spacelab-ufsc/daughterboards/README.md

# daughterboards
OBDH 2.0 daughterboards
