spacelab-ufsc/daughterboards/Memory_Expansion_Daughter_Board/hardware/README.md

Hardware of the Memory Expansion Daughter Board
