spacelab-ufsc/daughterboards/Memory_Expansion_Daughter_Board/firmware/README.md

Firmware for Memory Expansion Daughter Board
