spacelab-ufsc/daughterboards/Memory_Expansion_Daughter_Board/doc/chapters/hardware.tex

%
% hardware.tex
%
% Copyright © 2020 by Universidade Federal de Santa Catarina.
%
% Memory Expansion Daughterboard of OBDH 2.0
%
% This work is licensed under the Creative Commons Attribution-ShareAlike 4.0
% International License. To view a copy of this license,
% visit http://creativecommons.org/licenses/by-sa/4.0/.
%

%
% \brief: Hardware chapter.
%
% \author: Yan Castro de Azeredo <yan.ufsceel@gmail.com>
%
% \institution: Universidade Federal de Santa Catarina (UFSC)
%
% \version: 0.1.0
%
% \date: 09/06/20 (DD/MM/YY)
%
%  Credits to Gabriel Mariano Marcelino <gabriel.mm8@gmail.com> for the creation of this template
%

\chapter{Hardware} \label{ch:hardware}

\begin{figure}[!ht]
    \begin{center}
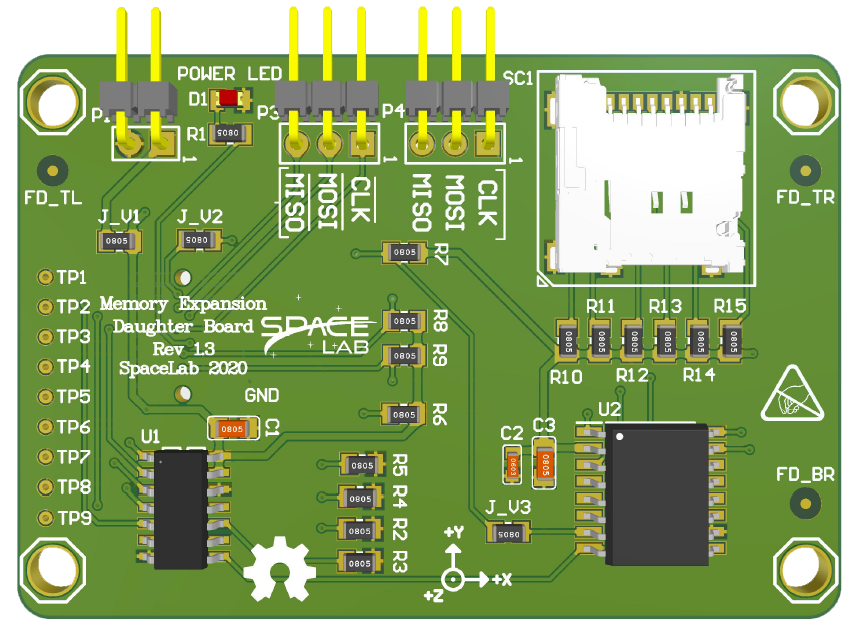
[picture p1: Memory_Expansion_Daughter_Board/doc/figures/TopView_DB_Memory.png]
        
        \caption{Top 3D view of the DB Memory PCB.}
        \label{fig:pcb-3d-TopView}
    \end{center}
\end{figure}

\begin{figure}[!ht]
    \begin{center}
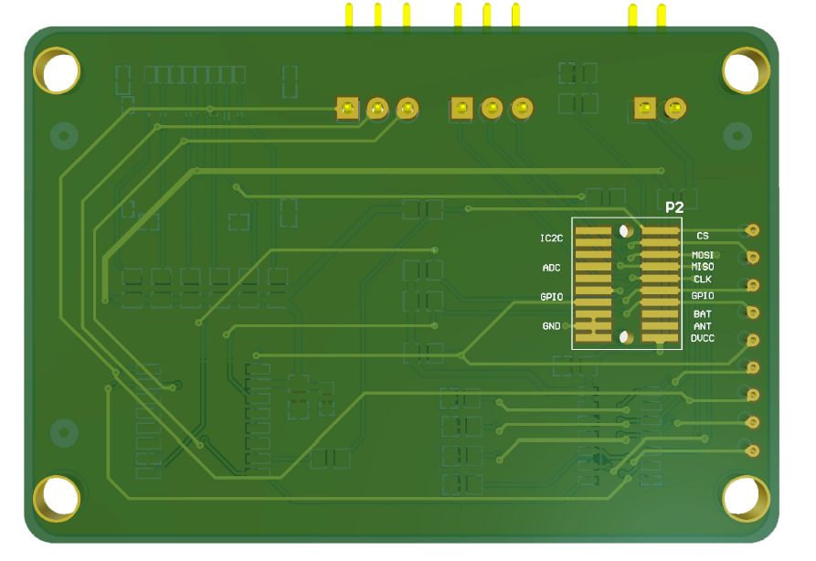
[picture p2: Memory_Expansion_Daughter_Board/doc/figures/BottomView_DB_Memory.png]
        
        \caption{Bottom 3D view of the DB Memory PCB.}
        \label{fig:pcb-3d-BottomView}
    \end{center}
\end{figure}
