spacelab-ufsc/daughterboards/Memory_Expansion_Daughter_Board/doc/chapters/introduction.tex

%
% introduction.tex
%
% Copyright © 2020 by Universidade Federal de Santa Catarina.
%
% Memory Expansion Daughterboard of OBDH 2.0
%
% This work is licensed under the Creative Commons Attribution-ShareAlike 4.0
% International License. To view a copy of this license,
% visit http://creativecommons.org/licenses/by-sa/4.0/.
%

%
% \brief: Introduction file.
%
% \author: Yan Castro de Azeredo <yan.ufsceel@gmail.com>
%
% \institution: Universidade Federal de Santa Catarina (UFSC)
%
% \version: 0.1.0
%
% \date: 09/06/20 (DD/MM/YY)
%
%  Credits to Gabriel Mariano Marcelino <gabriel.mm8@gmail.com> for the creation of this template
%

\chapter{Introduction} \label{ch:introduction}

The Memory Expansion Daughterboard (DB Memory in short) is a expansion module for the On-Boad-Data-Handling (OBDH 2) 
of FloripaSat-2 2U CubeSat. The main purpose of DB Memory is to give more 1gb non-volatile flash memory 
though an integrated circuit (MT25QL01GBBB) and more if added a micro sd card. 
While the module is not intended to go for flight in GOLDS-UFSC mission, 
the project had the main purpose to design the first board using the stadar SpaceLab daughter and motherboard relation 
and to serve as a prototype and testing printed circuit boards (PCB) for new comers in SpaceLab laboratory.

\begin{figure}[!ht]
    \begin{center}
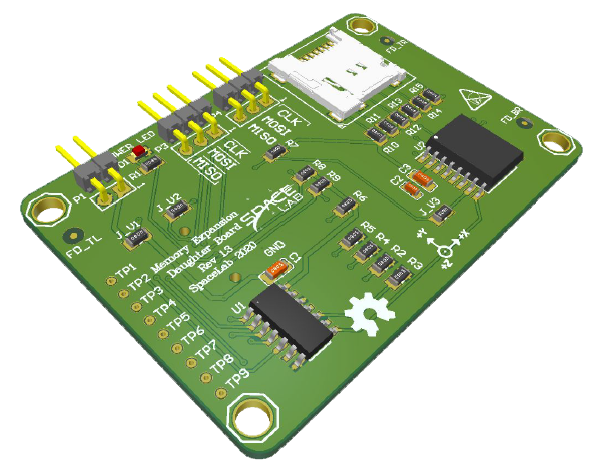
[picture p3: Memory_Expansion_Daughter_Board/doc/figures/DifferentView_DB_Memory.png]
        
        \caption{3D view of the DB Memory PCB.}
        \label{fig:pcb-3d-DifferentView}
    \end{center}
\end{figure}
