spacelab-ufsc/daughterboards/Memory_Expansion_Daughter_Board/doc/header/authorpage.tex

%
% authorpage.tex
%
% Copyright © 2020 by Universidade Federal de Santa Catarina.
%
% Memory Expansion Daughterboard of OBDH 2.0
%
% This work is licensed under the Creative Commons Attribution-ShareAlike 4.0
% International License. To view a copy of this license,
% visit http://creativecommons.org/licenses/by-sa/4.0/.
%

%
% \brief: Author page.
%
% \author: Yan Castro de Azeredo <yan.ufsceel@gmail.com>
%
% \institution: Universidade Federal de Santa Catarina (UFSC)
%
% \version: 0.1.0
%
% \date: 09/06/20 (DD/MM/YY)
%
%  Credits to Gabriel Mariano Marcelino <gabriel.mm8@gmail.com> for the creation of this template
%
\thispagestyle{empty}

\begin{center}

\textbf{\thetitle}

\textit{June, 2020}

\vspace{1cm}

\textbf{Project Chief:}

Eduardo Augusto Bezerra

\vspace{1cm}

\textbf{Authors:}

Yan Castro de Azeredo \\
Author 2 \\
Author 3 \\

\vspace{1cm}

\textbf{Contributing Authors:}

Author 1 \\
Author 2 \\
Author 3 \\

\vspace{1cm}

\textbf{Revision Control:}

\end{center}

\begin{table}[!ht]
    \begin{center}
        \begin{tabular}{cL{5cm}L{5.5cm}C{2cm}}
            \toprule[1.5pt]
            \textbf{Version} & \textbf{Author} & \textbf{Changes}    & \textbf{Date} \\
            \midrule
            0.1     & Yan Castro de Azeredo    & Document creation   & 06/2020    \\
                    &                          &                     &            \\
                    &                          &                     &            \\
                    &                          &                     &            \\
                    &                          &                     &            \\
            \bottomrule[1.5pt]
        \end{tabular}
    \end{center}
\end{table}

\vfill

\begin{figure}[!h]
	\begin{center}
		
	\end{center}
\end{figure}

\textcopyright\  2020 by Universidade Federal de Santa Catarina. Memory Expansion Daughterboard of OBDH 2.0. This work is licensed under the Creative Commons Attribution-ShareAlike 4.0 International License. To view a copy of this license, visit \href{http://creativecommons.org/licenses/by-sa/4.0/}{http://creativecommons.org/licenses/by-sa/4.0/}.
