spacelab-ufsc/daughterboards/Memory_Expansion_Daughter_Board/doc/main.pdf

SPACELAB.DB MEMORY.2020.06.001 REV A. ISSUE 0.1

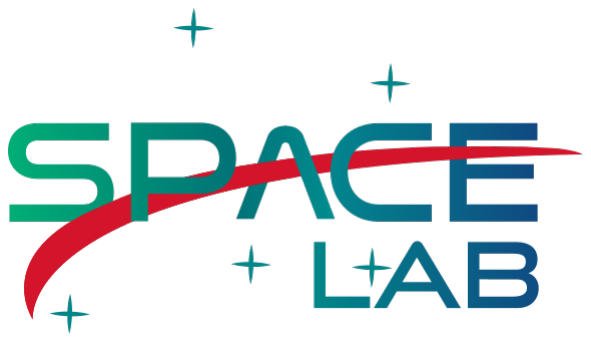
[picture p4: figure]

# Memory Expansion Daughterboard Documentation

Memory Expansion Daughterboard Documentation
SpaceLab, Universidade Federal de Santa Catarina, Florian´opolis - Brazil

June 2020

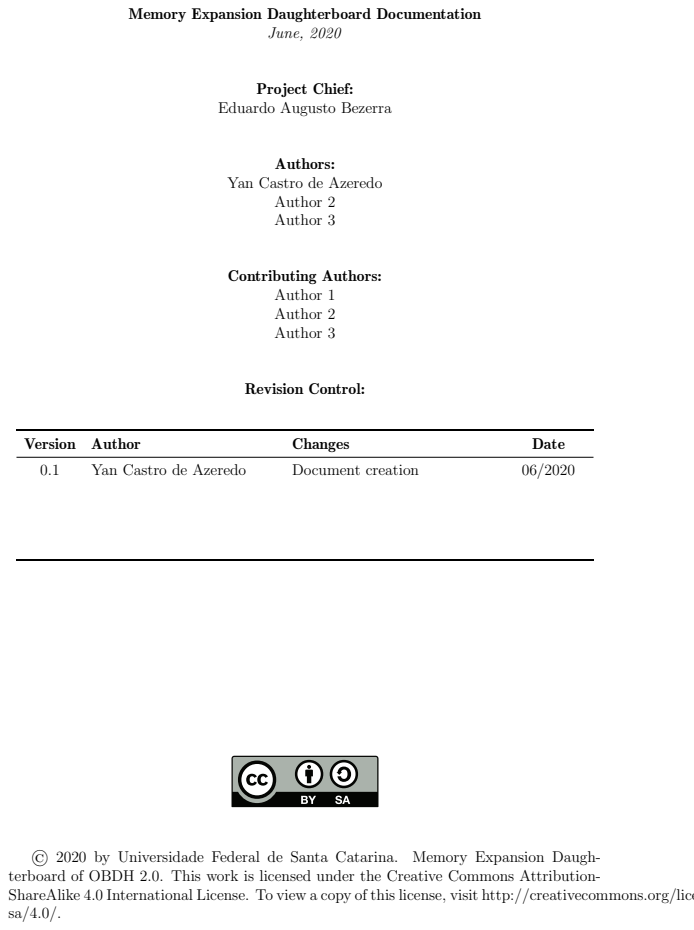
[picture p5: page 3]
June, 2020; Authors:; Author 2 Author 3; Contributing Authors: Author 1 Author 2 Author 3; Revision Control:; Version Author; Changes; Date; Yan Castro de Azeredo; Document creation

Memory Expansion Daughterboard Documentation

Project Chief:
Eduardo Augusto Bezerra

Yan Castro de Azeredo

© 2020 by Universidade Federal de Santa Catarina. Memory Expansion Daugh-
terboard of OBDH 2.0. This work is licensed under the Creative Commons Attribution-
ShareAlike 4.0 International License. To view a copy of this license, visit http://creativecommons.org/licenses/by-

## List of Figures

1.1 3D view of the DB Memory PCB | | 1
3.1 Top 3D view of the DB Memory PCB | | 5
3.2 Bottom 3D view of the DB Memory PCB | | 6

v

## List of Tables

vii

## Contents

List of Figures | v
Lista of Tables | vii
Nomenclature | vii
1 Introduction | 1
2 System Overview | 3
3 Hardware | 5
4 Firmware | 7
5 Usage Instructions | 9
References | 9

ix

## CHAPTER 1

## Introduction

The Memory Expansion Daughterboard (DB Memory in short) is a expansion module for the On-Boad-Data-Handling (OBDH 2) of FloripaSat-2 2U CubeSat. The main purpose of DB Memory is to give more 1gb non-volatile flash memory though an integrated circuit (MT25QL01GBBB) and more if added a micro sd card. While the module is not intended to go for flight in GOLDS-UFSC mission, the project had the main purpose to design the first board using the stadar SpaceLab daughter and motherboard relation and to serve as a prototype and testing printed circuit boards (PCB) for new comers in SpaceLab laboratory.

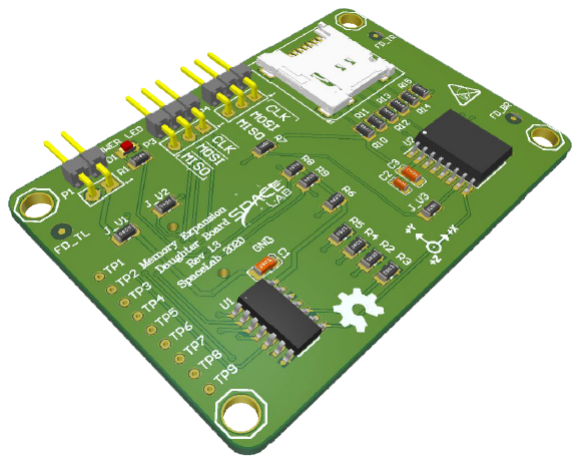
[picture p6: figure]

Figure 1.1: 3D view of the DB Memory PCB.

1

## CHAPTER 2

## System Overview

## 2.1 Block Diagram

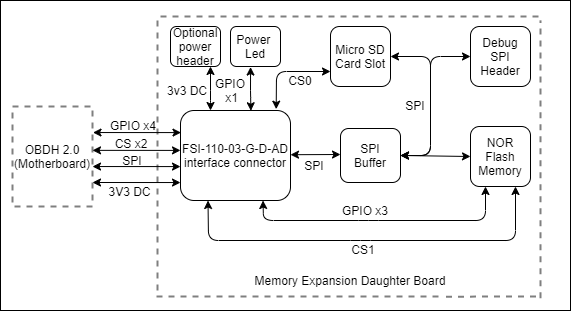
[picture p7: figure]

3

## CHAPTER 3

## Hardware

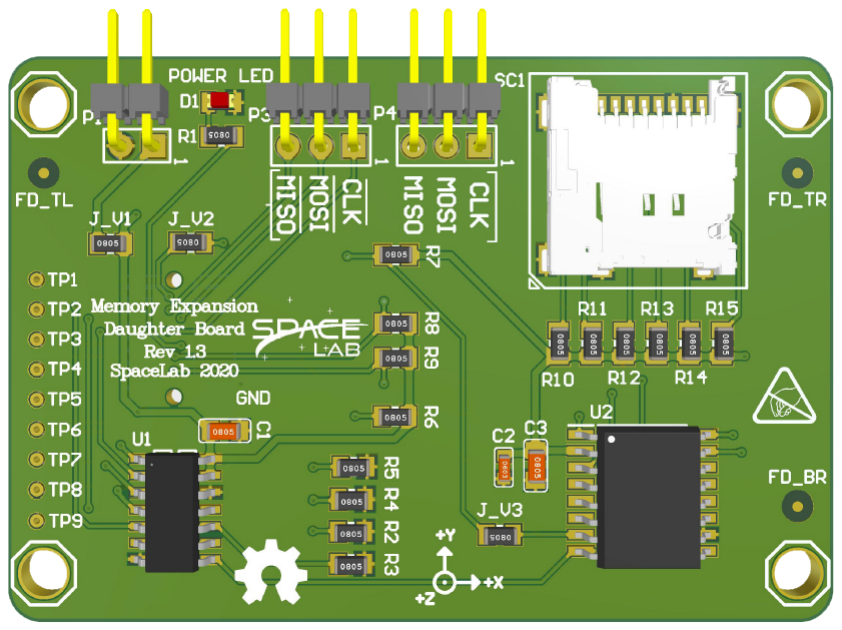
[picture p8: figure]

Figure 3.1: Top 3D view of the DB Memory PCB.

5

Chapter 3. Hardware

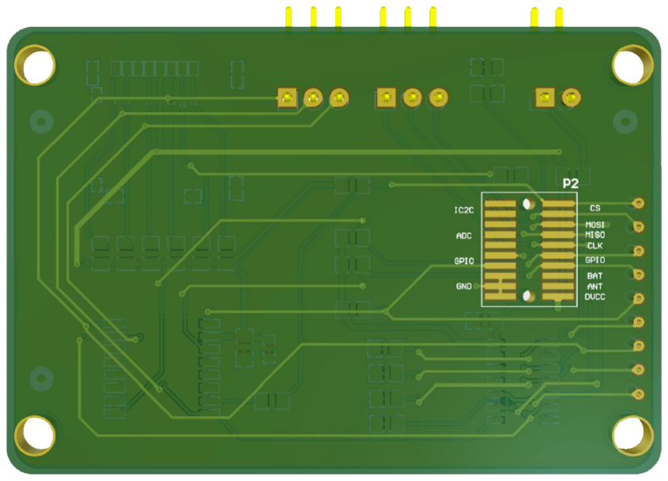
[picture p9: figure]

Figure 3.2: Bottom 3D view of the DB Memory PCB.

6

## CHAPTER 4

## Firmware

7

## CHAPTER 5

## Usage Instructions

9
