spacelab-ufsc/daughterboards/Memory_Expansion_Daughter_Board/hardware/PCB Design Checklist.xlsx

Excel sheet done by Kleber Reis Gouveia Júnior, Electronic Engineer, source: https://kleberrgouveia.wixsite.com/home/goodstuff
PCB Design Checklist
Project: Memory Expansion Daughter Board of OBDH 2.0 ALT Hardware |  |  | Revision: | 1.2
Variant: 1.0 |  |  | Date: | 2020-04-19
1. | Schematic
Description |  | OK | NOK | N/A | Comments
1.1 | 0R resistor to isolate power supplies. | X |  |  | Added to "POWER TEST" pin connector.
1.2 | Test points (power supplies, control and status signals, ...). | X
1.3 | Power indicator (LED). | X |  |  | Using GPIO 4.
1.4 | Initial state of control signals. | X
1.5 | Components power supplies (dual supply, voltage level). | X |  |  | Dual suply not necessary.
1.6 | Components polarity. |  |  | X
1.7 | Electrical junctions. | X
1.8 | Are there tatalum capacitors? Is it necessary? |  |  | X
1.9 | RC circuit (10k - 100nF) o uC RESET pin. |  |  | X
1.10 | uC programming/debug connector signals. | X
1.11 | Decoupling capacitors (10nF/100nF) on power supllies outputs. |  |  | X | OBDH 2.0 responsability.
1.12 | Decoupling capacitors (100nF) in power pins. | X |  |  | Used lower values of capacitance due to project aplication.
1.13 | Ferrite bead and decoupling capacitors in input signals from cables. | X |  |  | Only used extra capacitors on daughter board, ODBH 2.0 has ferrite breads and capacitors covered
1.14 | Differential pair rules. |  |  | X | This simple board design doesn't need it
1.15 | ESD, EFT, Surge Protection | X |  |  | Provided by mother board (OBDH 2.0) with a 1M ohm resistor connected to the structure
1.16 | Recompile project (C+R). | X
1.17 | Add Port Cross Reference (R+P+D). | X
2. | Layout
Description |  | OK | NOK | N/A | Comments
2.1 | Run DRC (T+D+R). | X
2.2 | Holes diameters (>=0,3mm). | X |  |  | FSI connector has 1.07 mm diameter alligment pin (AD version).
2.3 | Soldermask on thermal pads. | X
2.4 | Footprints - holes | X |  |  | Daughter Board PCB holes are standard for any variation.
2.5 | Footprints - dimensions (possible mirroring) |  | X* |  | *Only the FSI connector needing special revision for mating pads, no source found yet
2.6 | Pin 1 indication, component polarity indicator. | X |  |  | No polarity components on project.
2.7 | Compatibility between schematic models and pcb models. | X
2.8 | Track width | X |  |  | Power width of 0.508mm and all other tracks with 0.254mm (following standard of motherboard)
2.9 | Power lines | X
2.10 | Clearance between silk, silk to role and silk to silk. | X
2.11 | uC programming connector position. |  |  | X
2.12 | PCB stackup. | X |  |  | Same default thickness of OBDH 2.0
2.13 | PCB zoning. |  |  | X | This simple board design doesn't need it
2.14 | Copper tickness | X |  |  | Same default thickness of OBDH 2.0
2.15 | Tracks with controlled impedance. |  |  | X | Not a high speed design
2.16 | Heavy/Tall component on bottom layer. |  |  | X | Simple design that doesn't require it
2.17 | Acute angle on tracks. | X |  |  | No 90 degre tracks in pcb design
2.18 | Decoupling capacitors positioning. | X
2.19 | Company Logo. | X
2.20 | PCB code and revision | X
2.21 | Layers markers. |  |  | X | Only 2 layers.
2.22 | Stackup table. | X |  |  | Too large table and it is not yet know how to resize it in Altium 18.1.7
2.23 | Drill table. | X
2.24 | Silk RoHS, PB Free and ESD |  | X |  | Only ESD silk added
2.25 | Components fiducials. | X
2.26 | PCB fiducials. | X
2.27 | Mechanical holes. | X
2.28 | 3D .step bodies. | X
2.29 | Connectors counter parts assembly. |  |  | X | Simple design that doesn't require it
2.30 | Internal planes connections. | X |  |  | Only GND vias used in this simple 2 layer design
2.31 | Thermal reliefs between pads and poligons. | X
2.32 | Via stitching. |  |  | X | Simple design that doesn't require it
2.33 | Via tenting. | X
2.34 | Test points. | X
2.35 | Teadrops. | X
2.36 | Make PCB Re-annotate and SCH Back annotate. | X
3. | Documentation
Description |  | OK | NOK | N/A | Comments
3.1 | .OutJob file configuration. | X
3.2 | BOM.xls | X
3.3 | QUOTE.xls |  |  | X
3.4 | SCH.pdf | X |  |  | In a unified PDF containing layer prints, assembly drawings and BOM.
3.5 | GERBERS.zip | X
3.6 | NC Drill files.zip | X
3.7 | Pick and Place files.zip | X
3.8 | ODB++.zip | X
3.9 | Special Fabrication Instruction.pdf |  |  | X
4. | Technical Responsibles
Name |  | Role |  |  | Signature
4.1 | Yan Castro de Azeredo | Drawing
4.2 | André Martins Pio de Mattos | Reviewer and Support
4.3 | Gabriel Mariano Marcelino | Reviewer and Support
4.4 | Kleber Reis Gouveia Júnior | Reviewer and Support
