spacelab-ufsc/daughterboards/Memory_Expansion_Daughter_Board/README.md

## Memory Expansion Daughter Board for OBDH 2.0 (DB Memory)

<p align="center">

</p>

<p align="center">

</p>

<p align="center">

</p>
