spacelab-ufsc/daughterboards/Memory_Expansion_Daughter_Board/doc/header/titlepage.tex

%
% titlepage.tex
%
% Copyright © 2020 by Universidade Federal de Santa Catarina.
%
% Memory Expansion Daughterboard of OBDH 2.0
%
% This work is licensed under the Creative Commons Attribution-ShareAlike 4.0
% International License. To view a copy of this license,
% visit http://creativecommons.org/licenses/by-sa/4.0/.
%

%
% \brief: Title page.
%
% \author: Yan Castro de Azeredo <yan.ufsceel@gmail.com>
%
% \institution: Universidade Federal de Santa Catarina (UFSC)
%
% \version: 0.1.0
%
% \date: 09/06/20 (DD/MM/YY)
%
%  Credits to Gabriel Mariano Marcelino <gabriel.mm8@gmail.com> for the creation of this template
%
\begin{titlepage}

\thispagestyle{empty}

\begin{flushleft}
SPACELAB.DB MEMORY.2020.06.001 REV A. ISSUE 0.1
\end{flushleft}

\begin{figure}[!ht]
    \begin{flushleft}
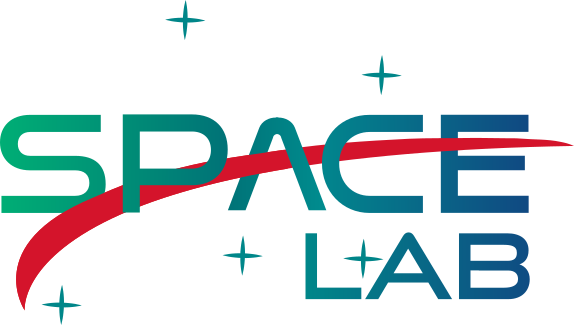
[picture p10: Memory_Expansion_Daughter_Board/doc/figures/LogotipoSpaceLab.png]
        
    \end{flushleft}
\end{figure}

\begin{flushleft}
\Huge{\textbf{\thetitle}}
\rule[0pt]{\textwidth}{5pt}
\end{flushleft}

\vspace{0.2cm}

\begin{flushleft}
\textit{Memory Expansion Daughterboard Documentation} \\
\textit{SpaceLab, Universidade Federal de Santa Catarina, Florianópolis - Brazil}
\end{flushleft}

\vfill
\vfill

\begin{flushright}
June 2020
\end{flushright}

\end{titlepage}
