spacelab-ufsc/daughterboards/Daughter_Board_Size_Shape/1_top_mating_pads_positioning.png

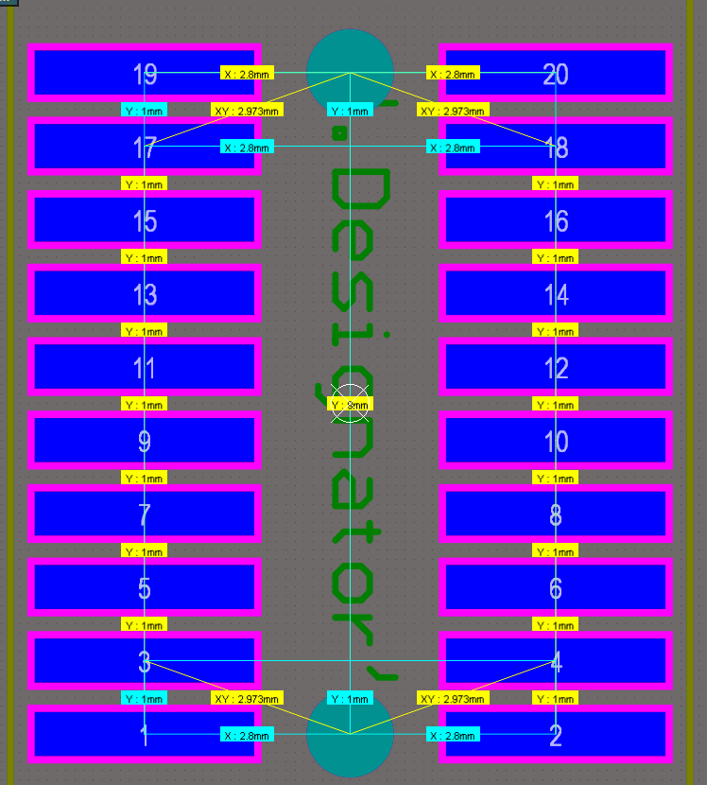
Daughter_Board_Size_Shape/1_top_mating_pads_positioning.png
