spacelab-ufsc/daughterboards/Daughter_Board_Size_Shape/2_top_mating_pads_size.png

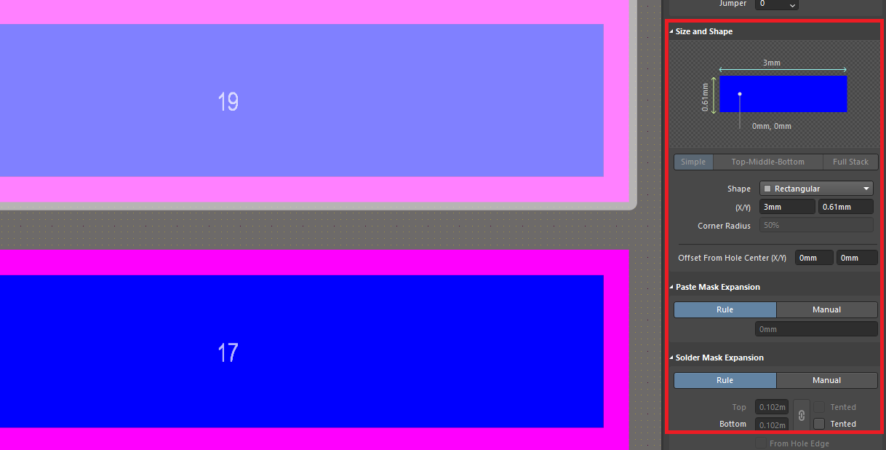
Daughter_Board_Size_Shape/2_top_mating_pads_size.png
