spacelab-ufsc/daughterboards/Daughter_Board_Size_Shape/3_connector_hole_size.png

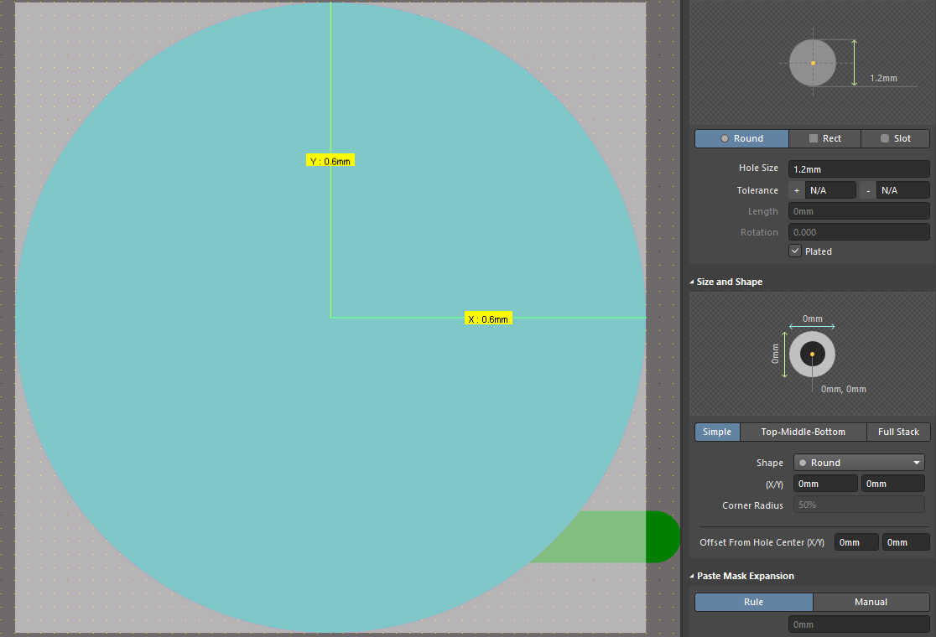
Daughter_Board_Size_Shape/3_connector_hole_size.png
