spacelab-ufsc/daughterboards/Daughter_Board_Size_Shape/4_connector_position.png

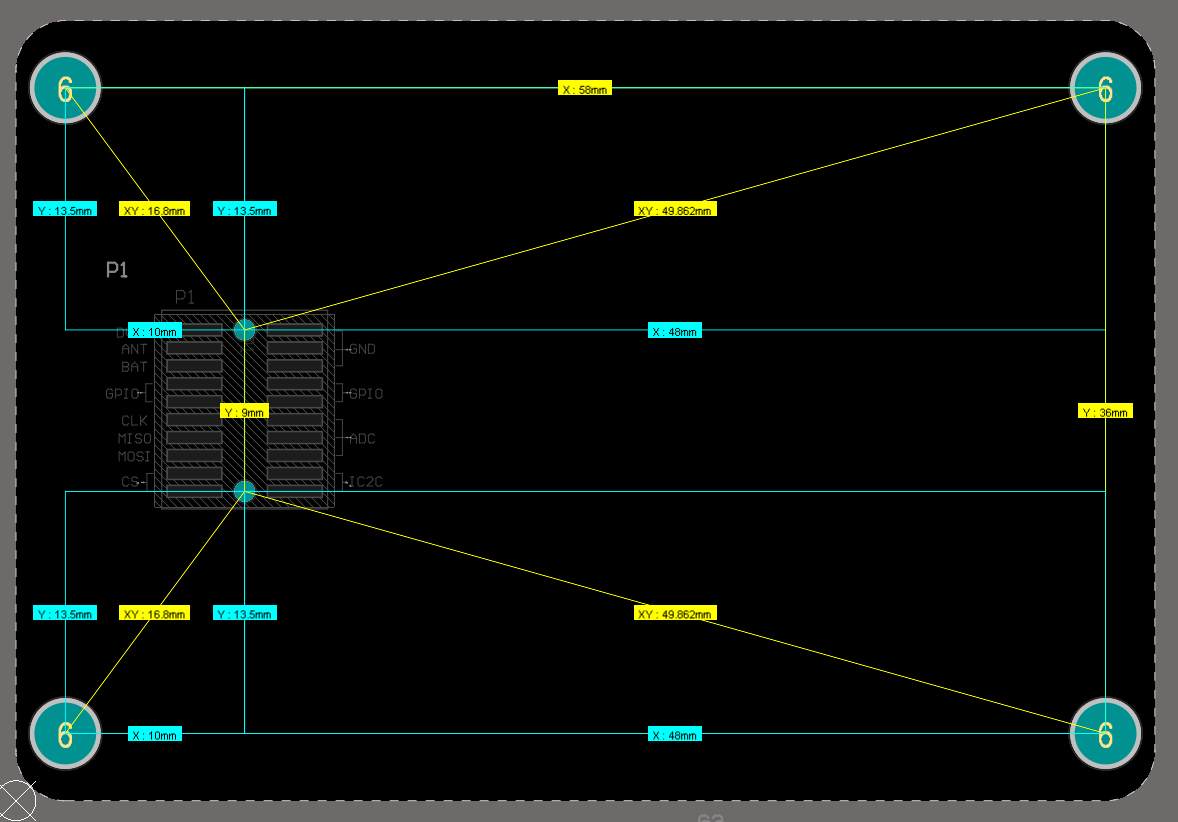
Daughter_Board_Size_Shape/4_connector_position.png
