spacelab-ufsc/daughterboards/Memory_Expansion_Daughter_Board/hardware/Output_files/Bill of Materials/Bill of Materials-DB_Memory.xlsx

 |  |  |  |  | Bill of Materials
 |  |  |  |  | Source Data From: | DB_Memory.PrjPCB
 |  |  |  |  | Project: | DB_Memory.PrjPCB
 |  |  |  |  | Variant: | None
 |  |  |  |  | Project Code: | <Parameter ProductCode not found>
 |  |  |  |  | Report Date: | 07/05/2020 | 11:25:48
 |  |  |  |  | Print Date: | 2020-05-07 | 11:26:10
# | Supplier 1 | Supplier Part Number 1 | Supplier 2 | Supplier Part Number 2 | Manufacturer | Comment | Description | Quantity | Designator | #Column Name Error:Fitted
1 | Digi-Key | 541-10.0KCCT-ND (https://octopart-clicks.com/click/altium?sku=541-10.0KCCT-ND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) | Mouser | 71-CRCW0805-10K-E3 (https://octopart-clicks.com/click/altium?sku=71-CRCW0805-10K-E3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) | Vishay | 10k | RES 10K OHM 1/8W 1% 0805 | 13 | R2, R3, R5, R6, R7, R8, R9, R10, R11, R12, R13, R14, R15
2 | Digi-Key | 311-0.0ARCT-ND (https://octopart-clicks.com/click/altium?sku=311-0.0ARCT-ND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) | Mouser | 603-RC0805JR-070RL (https://octopart-clicks.com/click/altium?sku=603-RC0805JR-070RL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) | Yageo | 0R | RES 0R OHM 1/8W JUMPER 0805 | 3 | J_V1, J_V2, J_V3
3 | Mouser | 200-TSW10308GSRA (https://octopart-clicks.com/click/altium?sku=200-TSW10308GSRA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) | Digi-Key | SAM1039-03-ND (https://octopart-clicks.com/click/altium?sku=SAM1039-03-ND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) | Samtec | HEADER 3x | Conn Unshrouded Header HDR 3 POS 2.54mm Solder RA Thru-Hole Automotive Bulk | 2 | P3, P4
4 | Digi-Key | 160-1413-1-ND (https://octopart-clicks.com/click/altium?sku=160-1413-1-ND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) | Mouser | 859-LTST-C170KFKT (https://octopart-clicks.com/click/altium?sku=859-LTST-C170KFKT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) | Vishay Lite-On | Orange | SMD Orange LED | 1 | D1
5 | Digi-Key | 296-1222-1-ND (https://octopart-clicks.com/click/altium?sku=296-1222-1-ND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) | Mouser | 595-SN74LVC125APWR (https://octopart-clicks.com/click/altium?manufacturer=Texas%20Instruments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) | Texas Instruments | SN74LVC125APWR | IC BUF NON-INVERT 3.6V 14TSSOP | 1 | U1
6 | Digi-Key | 311-100KCRCT-ND (https://octopart-clicks.com/click/altium?sku=311-100KCRCT-ND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) | Mouser | 603-RC0805FR-07100KL (https://octopart-clicks.com/click/altium?sku=603-RC0805FR-07100KL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) | Yageo | 100k | RES 100K OHM 1/8W 1% 0805 | 1 | R4
7 | Digi-Key | 311-1141-1-ND (https://octopart-clicks.com/click/altium?sku=311-1141-1-ND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) | Mouser | 603-CC805KRX7R8BB104 (https://octopart-clicks.com/click/altium?sku=603-CC805KRX7R8BB104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) | Yageo | 0.1uF/25V | CAP CER 0.1UF 25V 10% X7R 0805 | 1 | C1
8 | Digi-Key | 311-1401-1-ND (https://octopart-clicks.com/click/altium?sku=311-1401-1-ND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) | Mouser | 603-CC201KRX7R9BB101 (https://octopart-clicks.com/click/altium?sku=603-CC201KRX7R9BB101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) | Yageo | 100nF/50V | CAP CER 100nF 50V 0603 10% | 1 | C2
9 | Digi-Key | 587-2990-6-ND (https://octopart-clicks.com/click/altium?sku=587-2990-6-ND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) | Mouser | 963-TMK212AB7475KG-T (https://octopart-clicks.com/click/altium?sku=963-TMK212AB7475KG-T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) | Taiyo Yuden | 4.7uF/25V | CAP CER 4.7UF 25V 10% X7R 0805 | 1 | C3
10 | Digi-Key | 2019-RK73H2ATTD3300FCT-ND (https://octopart-clicks.com/click/altium?manufacturer=KOA%20Speer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) | Mouser | 660-RK73H2ATTD3300F (https://octopart-clicks.com/click/altium?sku=660-RK73H2ATTD3300F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) | KOA Speer | 330R | RES 330R OHM 1/4W 1% 0805 | 1 | R1
11 | Mouser | 200-FSI11003GDAD (https://octopart-clicks.com/click/altium?sku=200-FSI11003GDAD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) | Digi-Key | SAM9412-ND (https://octopart-clicks.com/click/altium?sku=SAM9412-ND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) | Samtec | FSI-110-03-G-D-AD | CONN STACKING 20POS SMD GOLD | 1 | P2
12 | Mouser | 200-TSW10208GSRA (https://octopart-clicks.com/click/altium?sku=200-TSW10208GSRA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) | Digi-Key | SAM1039-02-ND (https://octopart-clicks.com/click/altium?sku=SAM1039-02-ND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) | Samtec | HEADER 2x | Conn Unshrouded Header HDR 2 POS 2.54mm Solder RA Thru-Hole Automotive Bulk | 1 | P1
13 | Mouser | 340-278808-TRAY (https://octopart-clicks.com/click/altium?manufacturer=Micron%20Technology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) | Digi-Key | 557-1789-ND (https://octopart-clicks.com/click/altium?manufacturer=Micron%20Technology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) | Micron Technology | MT25QL01GBBB8ESF-0SIT | NOR Flash Serial-SPI 3V 1Gbit 1024M/512M/256M x 1bit/2bit/4bit 6ns 16-Pin SOP-II | 1 | U2
14 | Mouser | 538-503182-1852 (https://octopart-clicks.com/click/altium?sku=538-503182-1852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) | Digi-Key | WM12834CT-ND (https://octopart-clicks.com/click/altium?sku=WM12834CT-ND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) | Molex | MicroSD Card Connector | MOLEX - 503182-1852 - Micro SD Normal UltraLowPro8CktEmbsTpPkg RoHS Compliant: Yes | 1 | SC1
