spacelab-ufsc/daughterboards/Memory_Expansion_Daughter_Board/hardware/Output_files/Bill of Materials/BOM Template.xlsx

 |  |  |  |  | Bill of Materials
 |  |  |  |  | Source Data From: | Field=DataSourceFileName
 |  |  |  |  | Project: | Field=ProjectFileName
 |  |  |  |  | Variant: | Field=VariantName
 |  |  |  |  | Project Code: | Field=ProductCode
 |  |  |  |  | Report Date: | Field=ReportDate | Field=ReportTime
 |  |  |  |  | Print Date: | 2020-03-21 | 13:29:34
# | Column=Supplier 1 | Column=Supplier Part Number 1 | Column=Supplier 2 | Column=Supplier Part Number 2 | Column=Manufacturer | Column=Comment | Column=Description | Column=Quantity | Column=Designator | Column=Fitted
1
2
3
