spacelab-ufsc/daughterboards/Memory_Expansion_Daughter_Board/hardware/3D models/User Library-0603(1608M) Cap.step

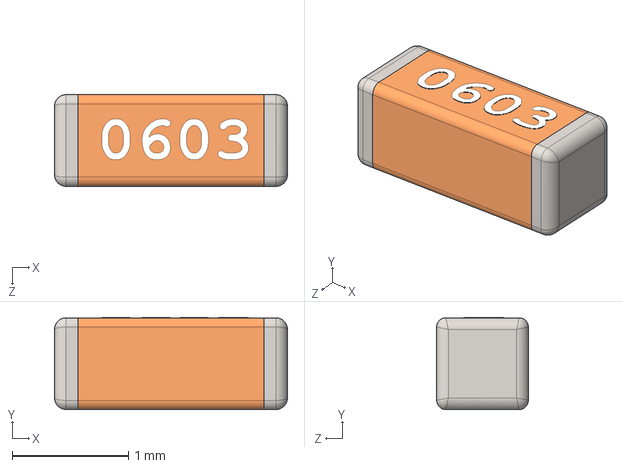
[picture p15: CAD file, 2020-02-14]
Memory_Expansion_Daughter_Board/hardware/3D models/User Library-0603(1608M) Cap.step
2.00 x 0.79 x 0.787 mm
