spacelab-ufsc/daughterboards/Memory_Expansion_Daughter_Board/hardware/3D models/User Library-0805(2012M) Cap.step

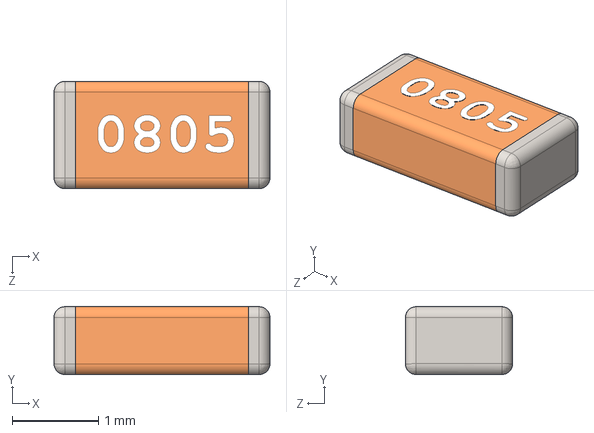
[picture p16: CAD file, 2020-02-14]
Memory_Expansion_Daughter_Board/hardware/3D models/User Library-0805(2012M) Cap.step
2.51 x 0.79 x 1.24 mm
