spacelab-ufsc/daughterboards/Memory_Expansion_Daughter_Board/hardware/3D models/User Library-led_0805.step

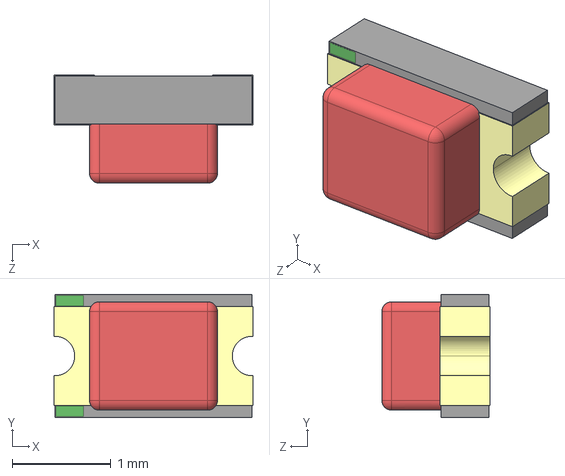
[picture p17: CAD file, 2020-02-14]
Memory_Expansion_Daughter_Board/hardware/3D models/User Library-led_0805.step
2.02 x 1.25 x 1.10 mm
