spacelab-ufsc/daughterboards/Memory_Expansion_Daughter_Board/hardware/3D models/PW14.step

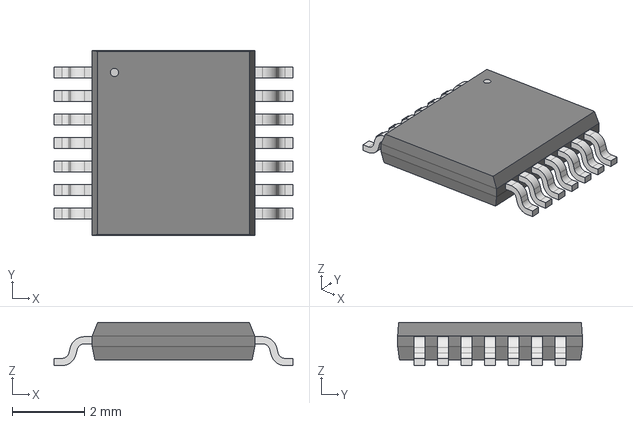
[picture p18: CAD file, 2020-02-14]
Memory_Expansion_Daughter_Board/hardware/3D models/PW14.step
6.60 x 5.11 x 1.20 mm
