spacelab-ufsc/daughterboards/Memory_Expansion_Daughter_Board/hardware/3D models/User Library-IPC SO.step

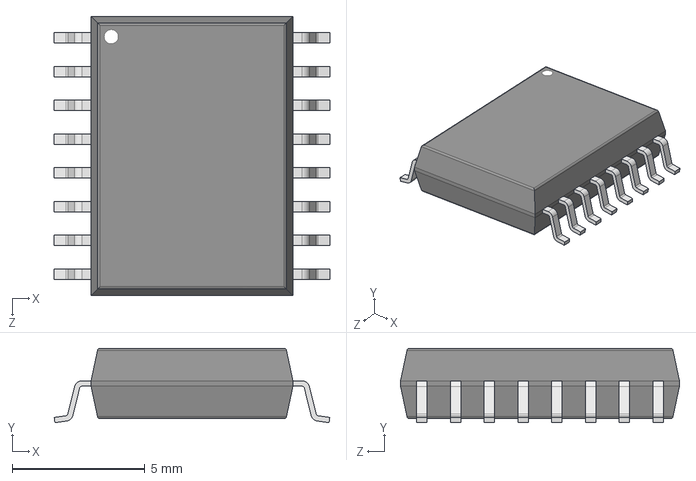
[picture p19: CAD file, 2020-02-14]
Memory_Expansion_Daughter_Board/hardware/3D models/User Library-IPC SO.step
10.4 x 2.80 x 10.5 mm
