spacelab-ufsc/daughterboards/Memory_Expansion_Daughter_Board/hardware/3D models/TSW-102-08-G-S-RA.stp

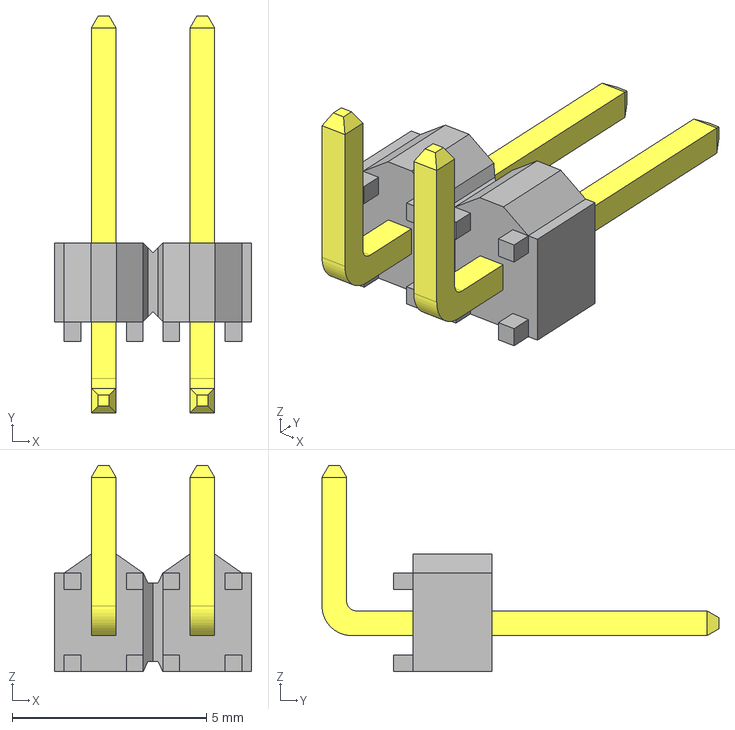
[picture p20: CAD file, 2020-02-04]
Memory_Expansion_Daughter_Board/hardware/3D models/TSW-102-08-G-S-RA.stp
5.08 x 10.2 x 5.31 mm
_TSW-102-08-G-S-RA_body
_T-1S6-08-TSW-1-08-2-RA-S
