spacelab-ufsc/daughterboards/Memory_Expansion_Daughter_Board/hardware/3D models/TSW-103-08-G-S-RA.stp

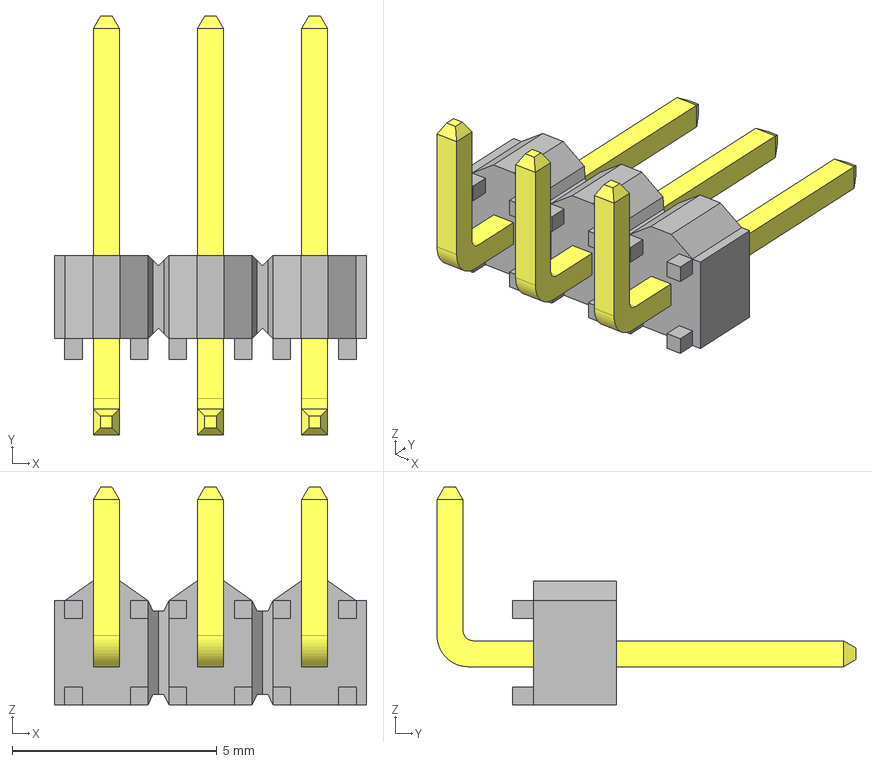
[picture p21: CAD file, 2020-02-04]
Memory_Expansion_Daughter_Board/hardware/3D models/TSW-103-08-G-S-RA.stp
7.62 x 10.2 x 5.31 mm
_TSW-103-08-G-S-RA_body
_T-1S6-08-TSW-1-08-3-RA-S
