spacelab-ufsc/daughterboards/Memory_Expansion_Daughter_Board/hardware/3D models/FSI-110-03-G-D-AD.stp

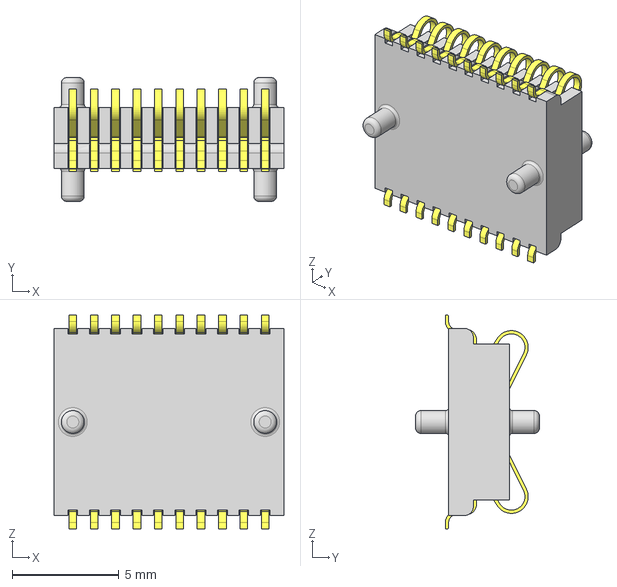
[picture p22: CAD file, 2020-02-04]
Memory_Expansion_Daughter_Board/hardware/3D models/FSI-110-03-G-D-AD.stp
10.8 x 5.80 x 10.0 mm
_FSI-110-03-G-D-AD_terminal
_FSI-110-03-D_pin x 2
