spacelab-ufsc/daughterboards/(list of files, cad)

Other CAD files:
Memory_Expansion_Daughter_Board/hardware/3D models/User Library-0805(2012M) Res.step
