spacelab-ufsc/daughterboards/Memory_Expansion_Daughter_Board/hardware/Multi_Board_Assembly_with_obdh2/Images/DB_ME_ODBH2_Assemble_XZ_plane_NegativeYaxis.png

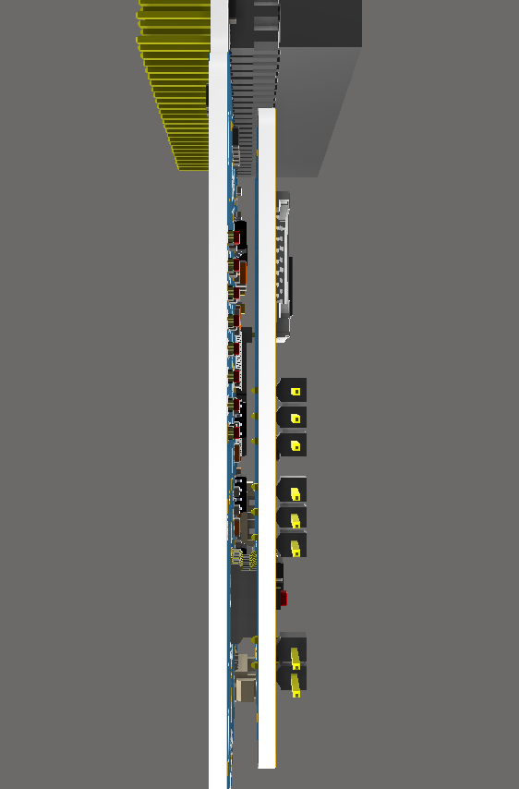
Memory_Expansion_Daughter_Board/hardware/Multi_Board_Assembly_with_obdh2/Images/DB_ME_ODBH2_Assemble_XZ_plane_NegativeYaxis.png
