spacelab-ufsc/daughterboards/Memory_Expansion_Daughter_Board/hardware/Multi_Board_Assembly_with_obdh2/Images/DB_ME_ODBH2_Assemble_Zaxis_distance.png

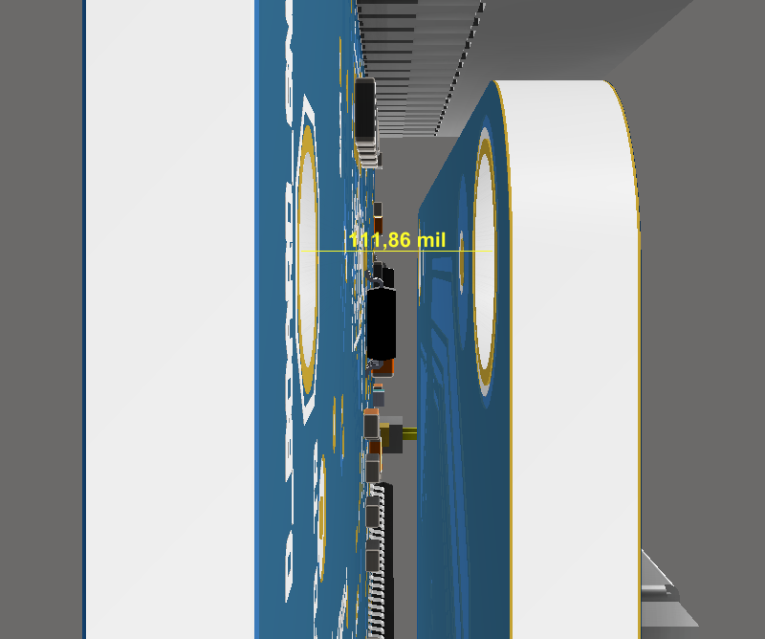
Memory_Expansion_Daughter_Board/hardware/Multi_Board_Assembly_with_obdh2/Images/DB_ME_ODBH2_Assemble_Zaxis_distance.png
