spacelab-ufsc/daughterboards/(threads)

Thread 1 (2020-01-28):

Define architecture and topology

andrempmattos, 2020-01-28:
Create 4 core schematic files: 0_Architecture, 1_Interface, 2_Non_Volatile_Memories and 3_Communication_Buffers.

Use two non volatile memory types (micro SD card and NOR flash, MT25QL01GBBB) and 1 SPI buffer (SN74LVC125A or similar).

andrempmattos, 2020-01-29:
16c9309cf4238662a09aade4e43ca6245ccd7089

andrempmattos, 2020-01-29:
e097bd7cd2205c9c41eca21c95c3306ac1006e75

Closed 2020-02-13.

Thread 3 (2020-01-28):

Create the "1_Interface" schematic sheet

andrempmattos, 2020-01-28:
Create the OBDH female connector([Samtec FSI-110-03-G-D-AD](https://www.samtec.com/products/fsi-110-03-g-d-ad)), Power on 3V3 LED and Debug Headers (before and after SPI buffer MOSI, MISO, CLK and CS signals and alternative power supply source).

Closed 2020-02-13.

Thread 4 (2020-01-28):

Create the "2_Non_Volatile_Memories" schematic sheet

andrempmattos, 2020-01-28:
Create SD card circuits (slot SD, capacitors and pull-up/down resistors) e NOR Flash Memory (memory, capacitors and pull-up/down resistors).

**Nor Flash Memory:** (MT25QL01GBBB8ESF)

From the [datasheet](https://www.micron.com/-/media/client/global/documents/products/data-sheet/nor-flash/serial-nor/mt25q/die-rev-b/mt25q_qlkt_l_01g_bbb_0.pdf) (page 79):

*"Normal precautions must be taken for supply line decoupling to stabilize the VCC supply. Each device in a system should have the VCC line decoupled by a suitable capacitor (**typically 100nF**) close to the package pins. At power-down, when VCC drops from the operating voltage to below the power-on-reset threshold voltage shown here, all operations are disabled and the device does not respond to any command."*

Reference design: [Technical Note - PCB Layout Design Guidelines](https://www.micron.com/-/media/client/global/documents/products/technical-note/nor-flash/tn2509_layout_guidelines_spi_nor_mt25q.pdf)

**SD Card:** (WM12834CT-ND)

Closed 2020-02-13.

Thread 6 (2020-01-28):

Create the PCB layout

andrempmattos, 2020-01-28:
**Preliminary Placement Suggestion:**
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

**Light brown:** SD card
**Dark red:** NOR Flash Memory
**Light blue:** Buffer IC
**Green:** 2.54mm Pitch Debug Headers
**Small blue and green shapes:** Passive components (resistors, capacitors and diodes)

Closed 2020-04-18.

Thread 7 (2020-01-28):

Perform a Multi Board Assembly between the Daughter Board and OBDH 2.0

andrempmattos, 2020-01-28:
[Multi Board Assembly](https://resources.altium.com/pcb-design-blog/the-best-tools-for-multi-board-pcb-systems-design)

Closed 2020-04-18.

Thread 12 (2020-02-14):

Add a PDF file with the schematics and top/bottom view of the 3D model of the PCB

mgm8, 2020-02-14:
Example: [Schematic_OBDH_Eng_Model_2_ALT_v02.pdf](https://github.com/spacelab-ufsc/obdh2/blob/master/hardware/Schematic_OBDH_Eng_Model_2_ALT_v02.pdf)

YanAzer, 2020-03-21:
Ontem fazendo o último documento do projeto (BOM) percebi que o resistor "RES 0R OHM 1/16W JUMPER 0805" usado tanto na OBDH Eng Model 2 como nesta placa filha não existe, pelo menos até onde pesquisei na Digi-Key e Mouser. O único package disponível para essa especificação de potência (1/16W) é o 0402, não achei nenhum que seja 0802 como especificado no Altium. @andrempmattos @mgm8

YanAzer, 2020-03-21:
Encontrei o partnumber no altium como sendo este: CRCW08050000Z0EA, pesquisando os resultados aparecem com o valor mínimo de 1/8W tendo o package de 0802 @andrempmattos @mgm8

YanAzer, 2020-03-21:
Ainda não consegui deixar o arquivo da BOM na Output Job File para pegar os parâmetros Do componente de memória e do cartão SD. Assim por enquanto atualizei manualmente neste commit https://github.com/spacelab-ufsc/daughterboards/commit/5777cbacb6b5473c9a48c96ffb7be911536bc317

YanAzer, 2020-03-24:
Agora o arquivo da BOM gerado automaticamente pelo Output Job File está pegando todos os parâmetros da template menos da coluna "fitted". O componente "RES 0R OHM 1/16W JUMPER 0805" foi alterado por um do mesmo package (0805) com valor de potência 1/8W, mais especificamente este aqui (https://www.digikey.com/products/en?keywords=311-0.0ARCT-ND) que também possuímos em estoque.

Closed 2020-04-18.

Thread 15 (2020-03-21):

Finish remaining output files for project

YanAzer, 2020-03-21:
1-) .OutJob file configuration
2-) BOM.xls
3-) QUOTE.xls
4-) SCH.pdf
5-) GERBERS.zip
6-) NC Drill files.zip
7-) Pick and Place files.zip
8-) ODB++.zip

Closed 2020-03-24.
