spacelab-ufsc/daughterboards/Memory_Expansion_Daughter_Board/hardware/Output_files/PDF/DB_Memory.PDF

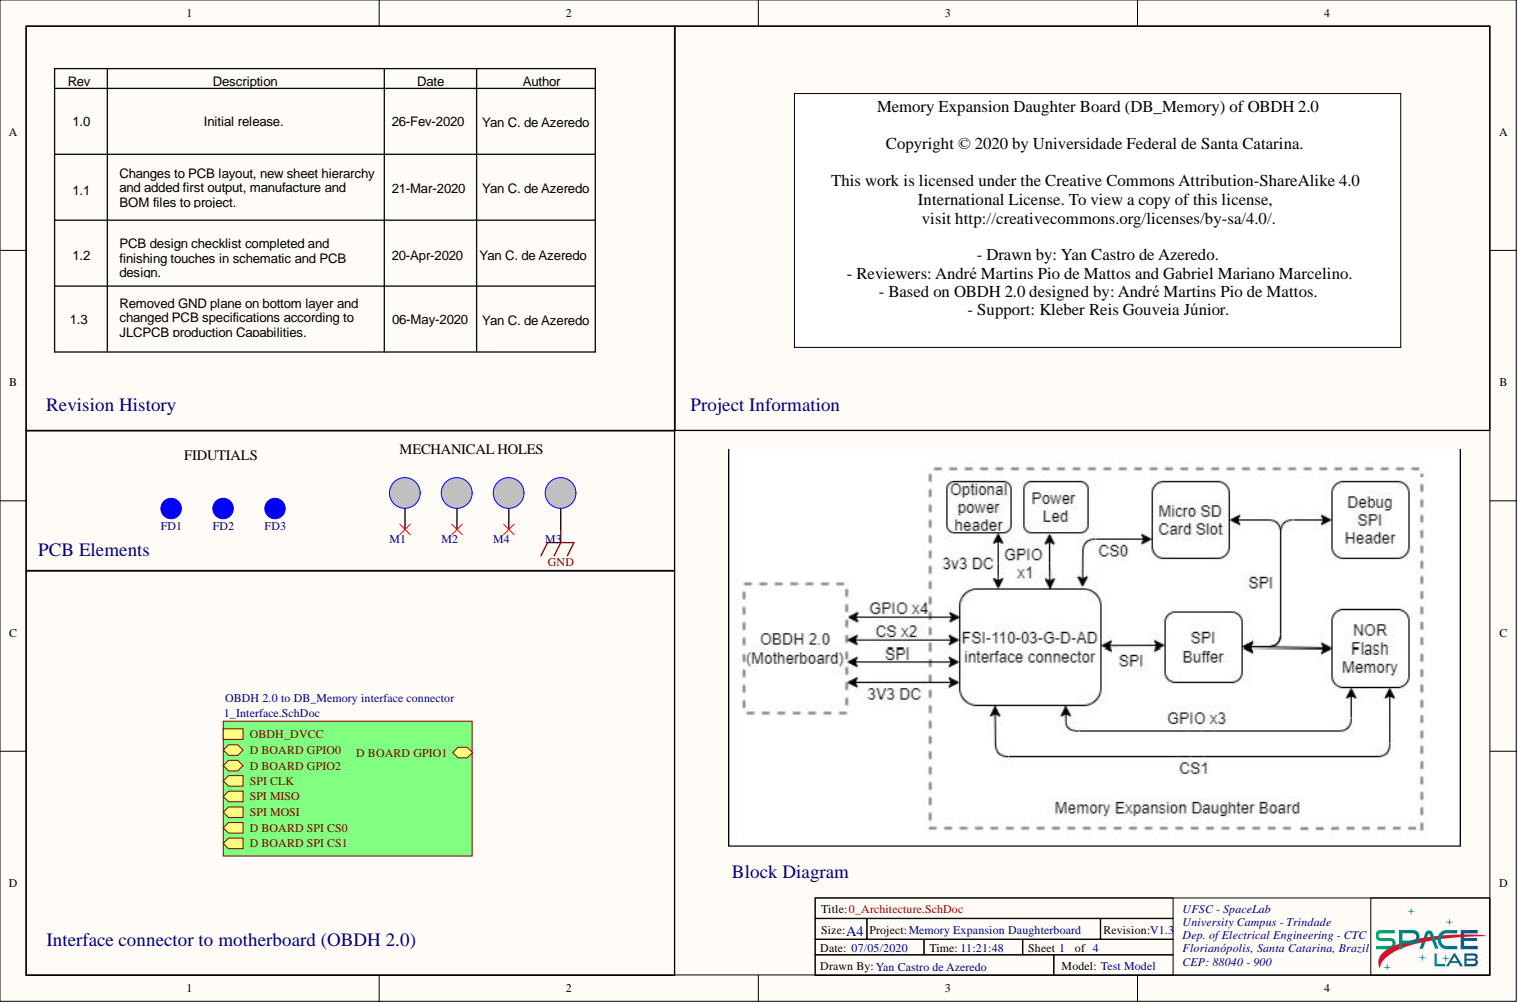
[picture p27: page 1]

R e v | D escri p t i o n | D a t e | Au t h o r

1 . 0 | I n i t i a l re l e ase . | 2 6-F ev-2 0 2 0 | Ya n C . d e Azere d o

Universidade Federal de Santa Catarina.

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

ive Com
To view a copy of
ivecom

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

ins Pio de Mat

únior

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

OBD
SPI MISO D BOARD GPIO
SPI CL

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

Size: A | Project : Memory E x pan s i o n Dau g h terb oard | Rev i s i o n : V 1.3

/ / | T ime: : : | Sheet o f
n By : Yan Cas tro de Azered o | Mo del : Tes t Mo del

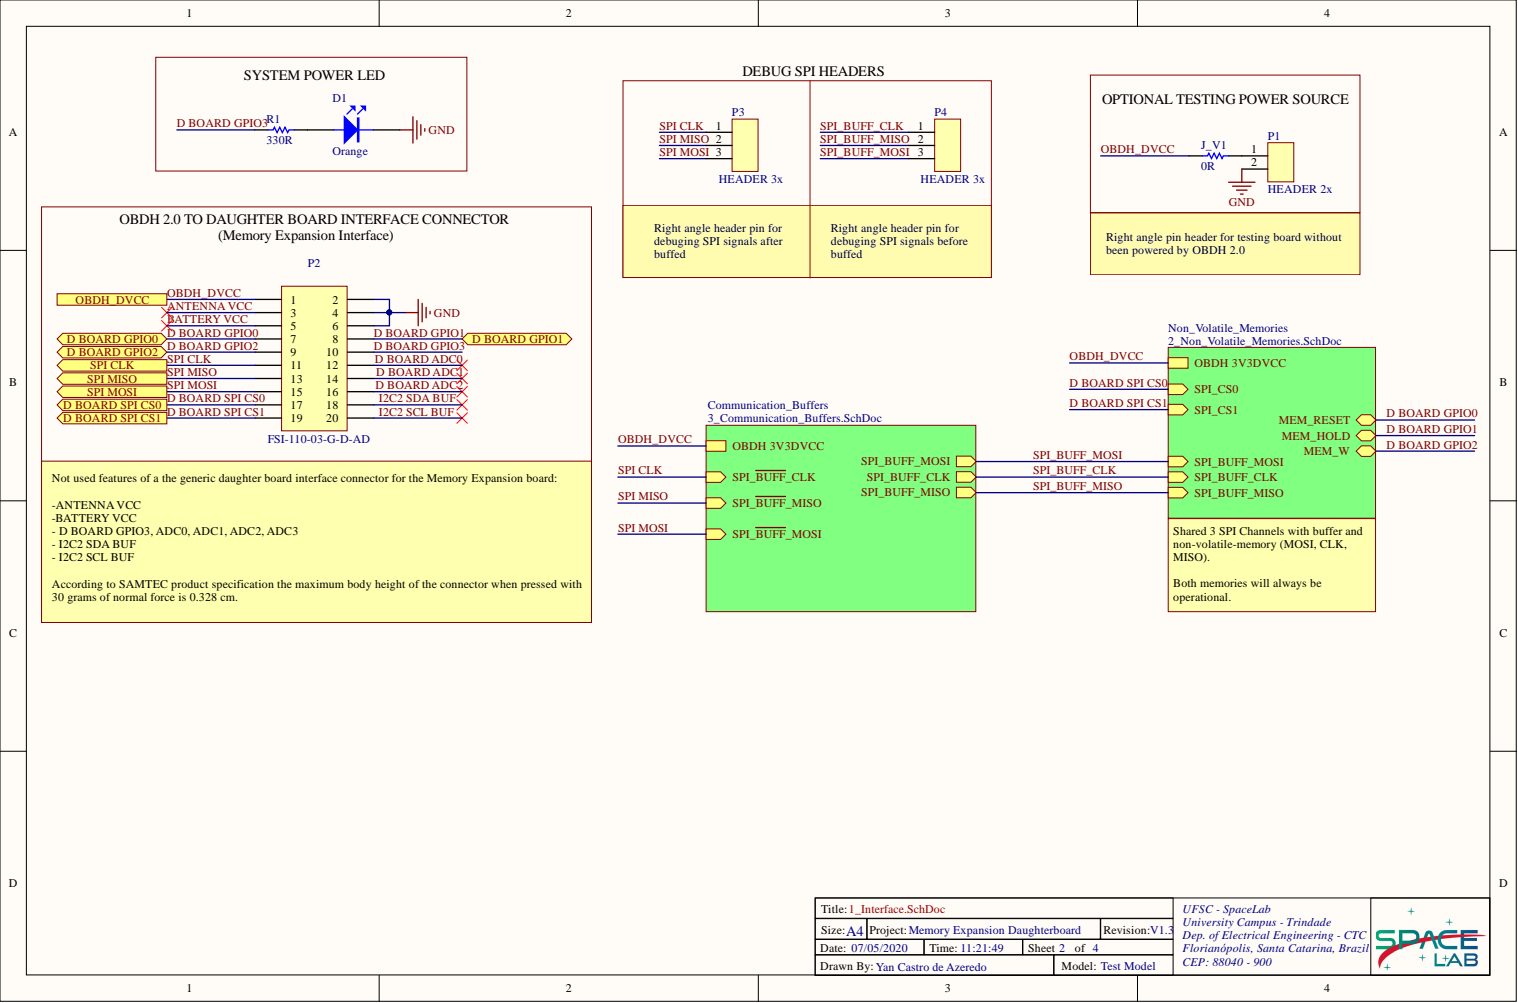
[picture p28: page 2]

OPTIONAL TESTING POWER SOURCE

OBDH 2.0 TO DAUGHTER BOARD INTERFACE CONNECTOR

Right angle header pin for
debuging SPI signals after
buffed

debuging SPI signals before

Right angle pin header for testing board without
been powered by OBDH 2.0

Not used features of a the generic daughter board interface connector for the Memory Expansion board:

Shared 3 SPI Channels with buffer and
non-volatile-memory (MOSI, CLK,
MISO).

Both memories will always be
operational.

According to SAMTEC product specification the maximum body height of the connector when pressed with
30 grams of normal force is 0.328 cm.

Title: 1_Interface.SchDoc | UFSC - SpaceLab University Campus - Trindade Dep. of Electrical Engineering - CTC Florianópolis, Santa Catarina, Brazil CEP: 88040 - 900

Size: A4 | Project: Memory Expansion Daughterboard | Revision: V1.3
Date: 07/05/2020 | Time: 11:21:49 | Sheet 2 of 4
Drawn By: Yan Castro de Azeredo | Model: Test Model

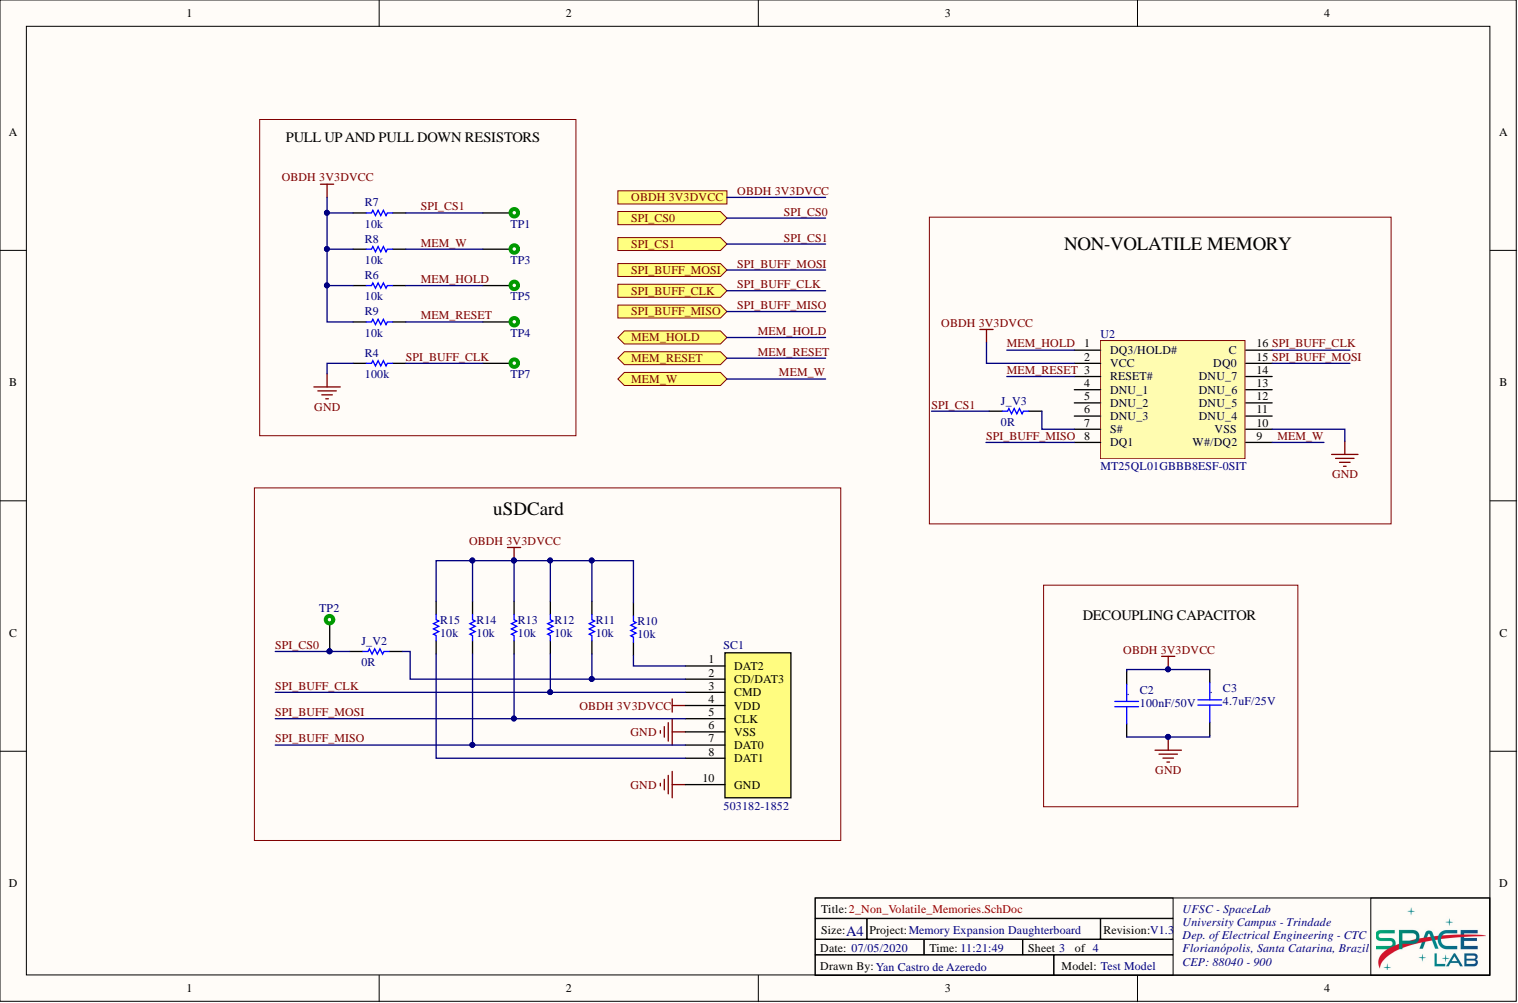
[picture p29: page 3]

PULL UPAND PULL DOWN RESISTORS

CMD 3 VDD 4

CLK 5 VSS 6

Title: 2_Non_Volatile_Memories.SchDoc | UFSC - SpaceLab University Campus - Trindade Dep. of Electrical Engineering - CTC Florianópolis, Santa Catarina, Brazil CEP: 88040 - 900

Size: A4 | Project: Memory Expansion Daughterboard | Revision: V1.3
Date: 07/05/2020 | Time: 11:21:49 | Sheet 3 of 4
Drawn By: Yan Castro de Azeredo | Model: Test Model

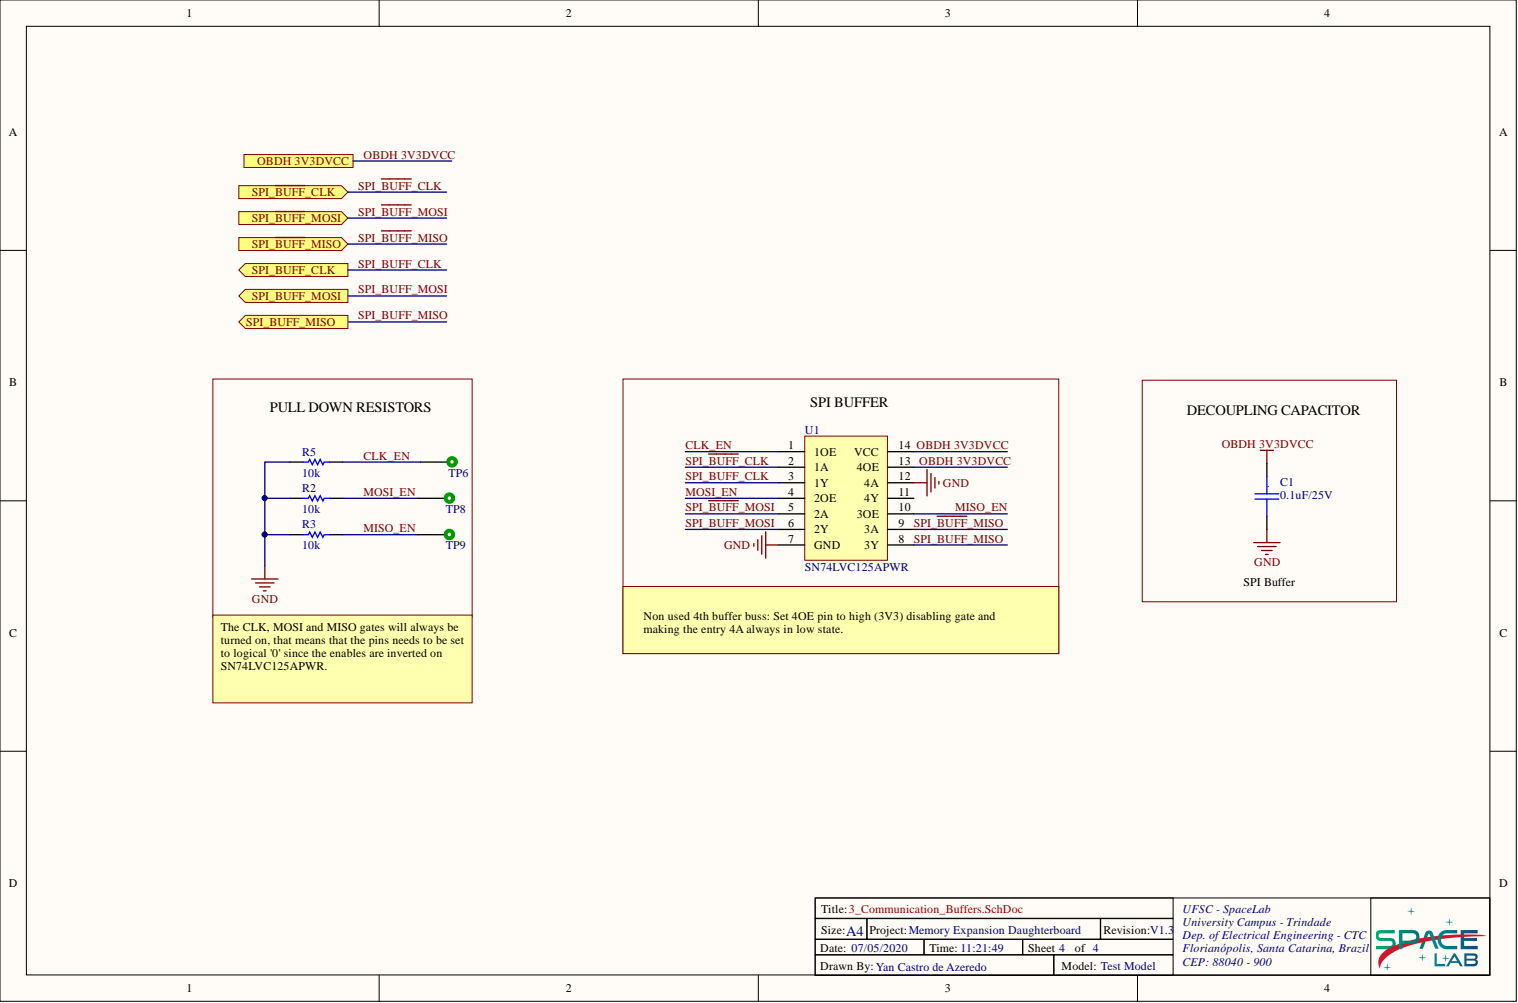
[picture p30: page 4]

The CLK, MOSI and MISO gates will always be
turned on, that means that the pins needs to be set
to logical '0' since the enables are inverted on
SN74LVC125APWR.

Non used 4th buffer buss: Set 4OE pin to high (3V3) disabling gate and
making the entry 4A always in low state.

Title: 3_Communication_Buffers.SchDoc | UFSC - SpaceLab University Campus - Trindade Dep. of Electrical Engineering - CTC Florianópolis, Santa Catarina, Brazil CEP: 88040 - 900

Size: A4 | Project: Memory Expansion Daughterboard | Revision: V1.3
Date: 07/05/2020 | Time: 11:21:49 | Sheet 4 of 4
Drawn By: Yan Castro de Azeredo | Model: Test Model

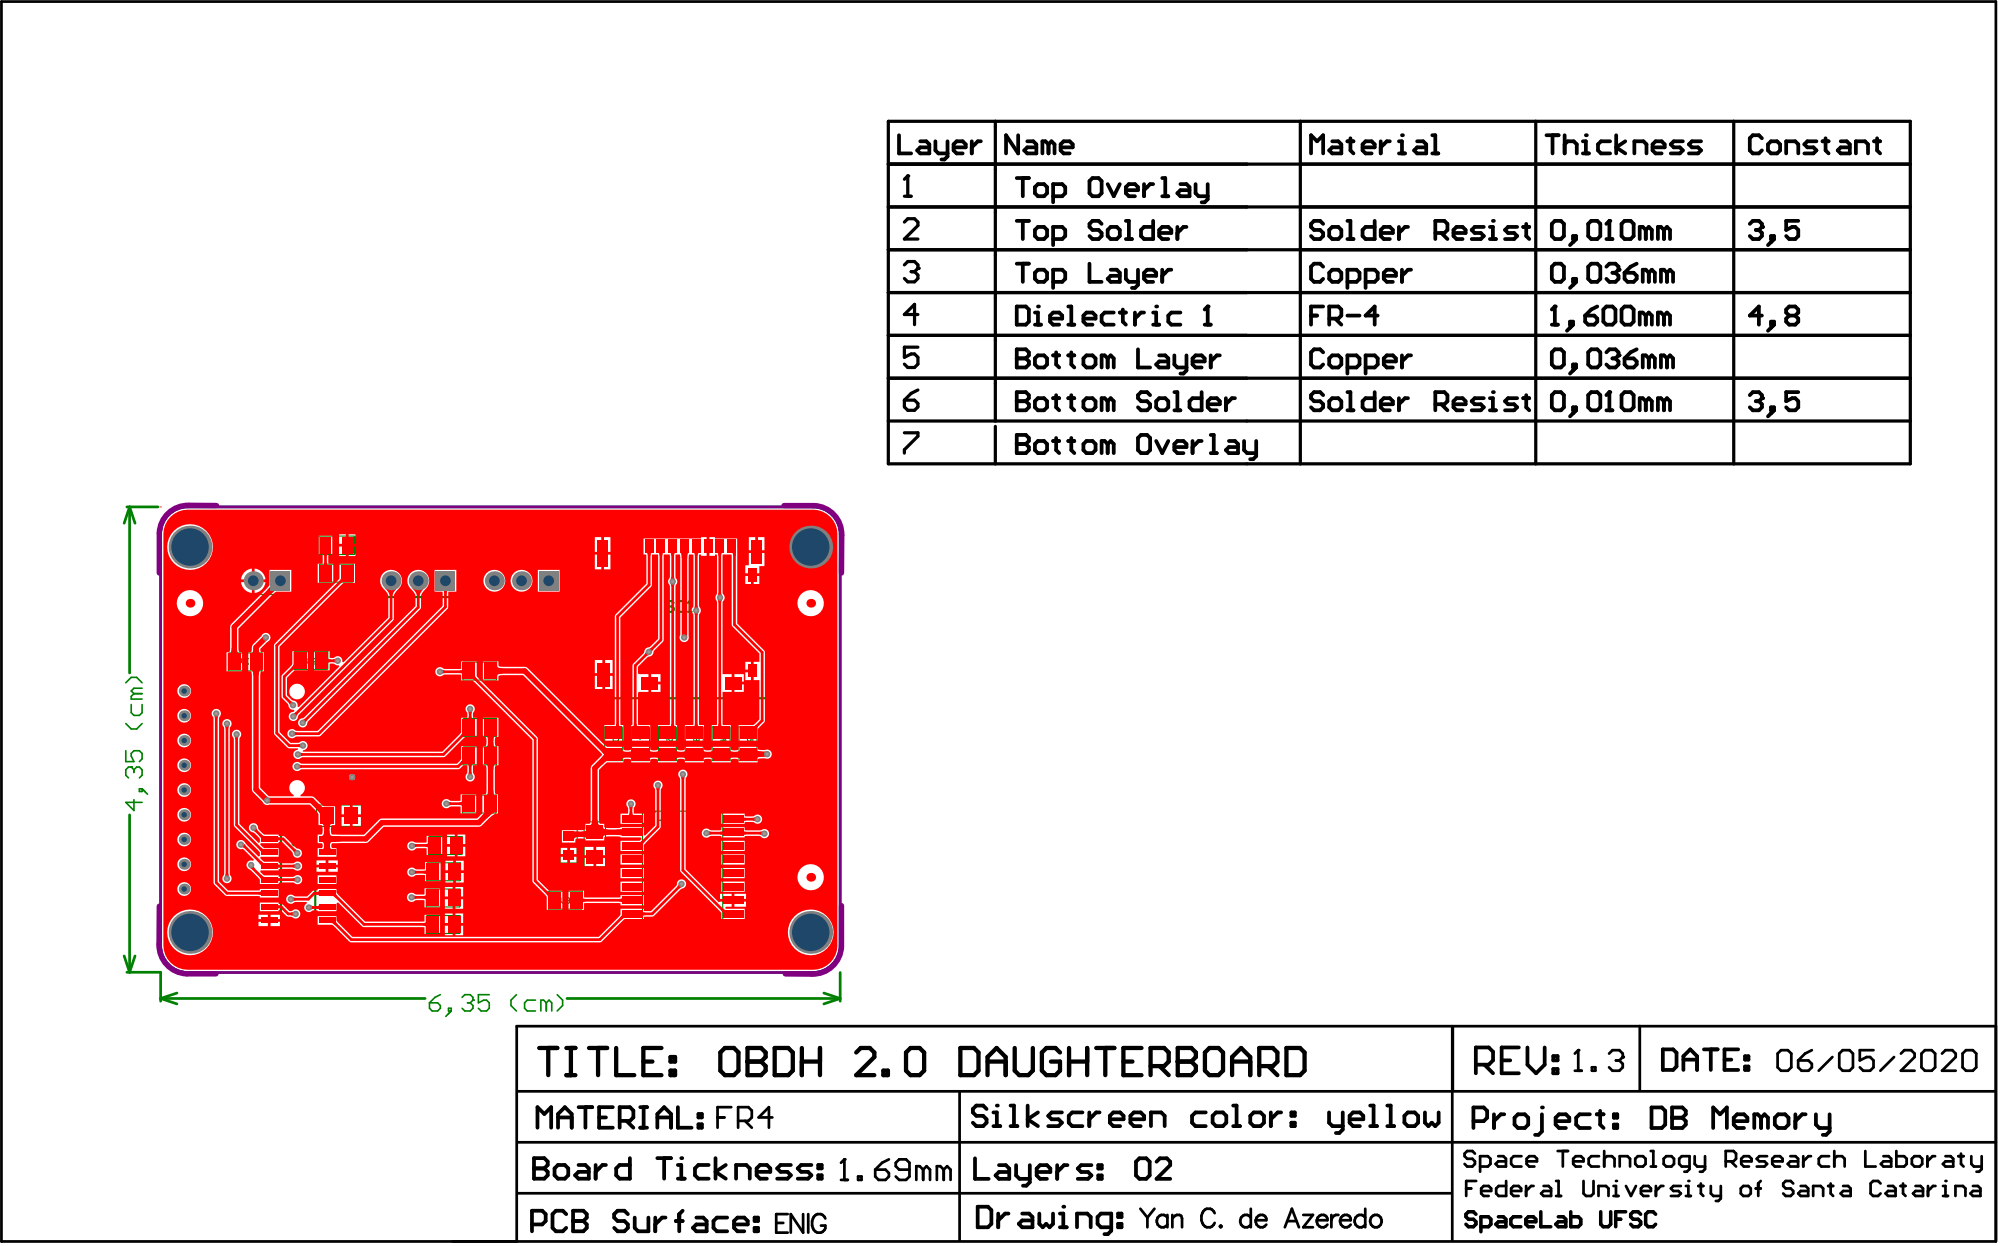
[picture p31: page 5]

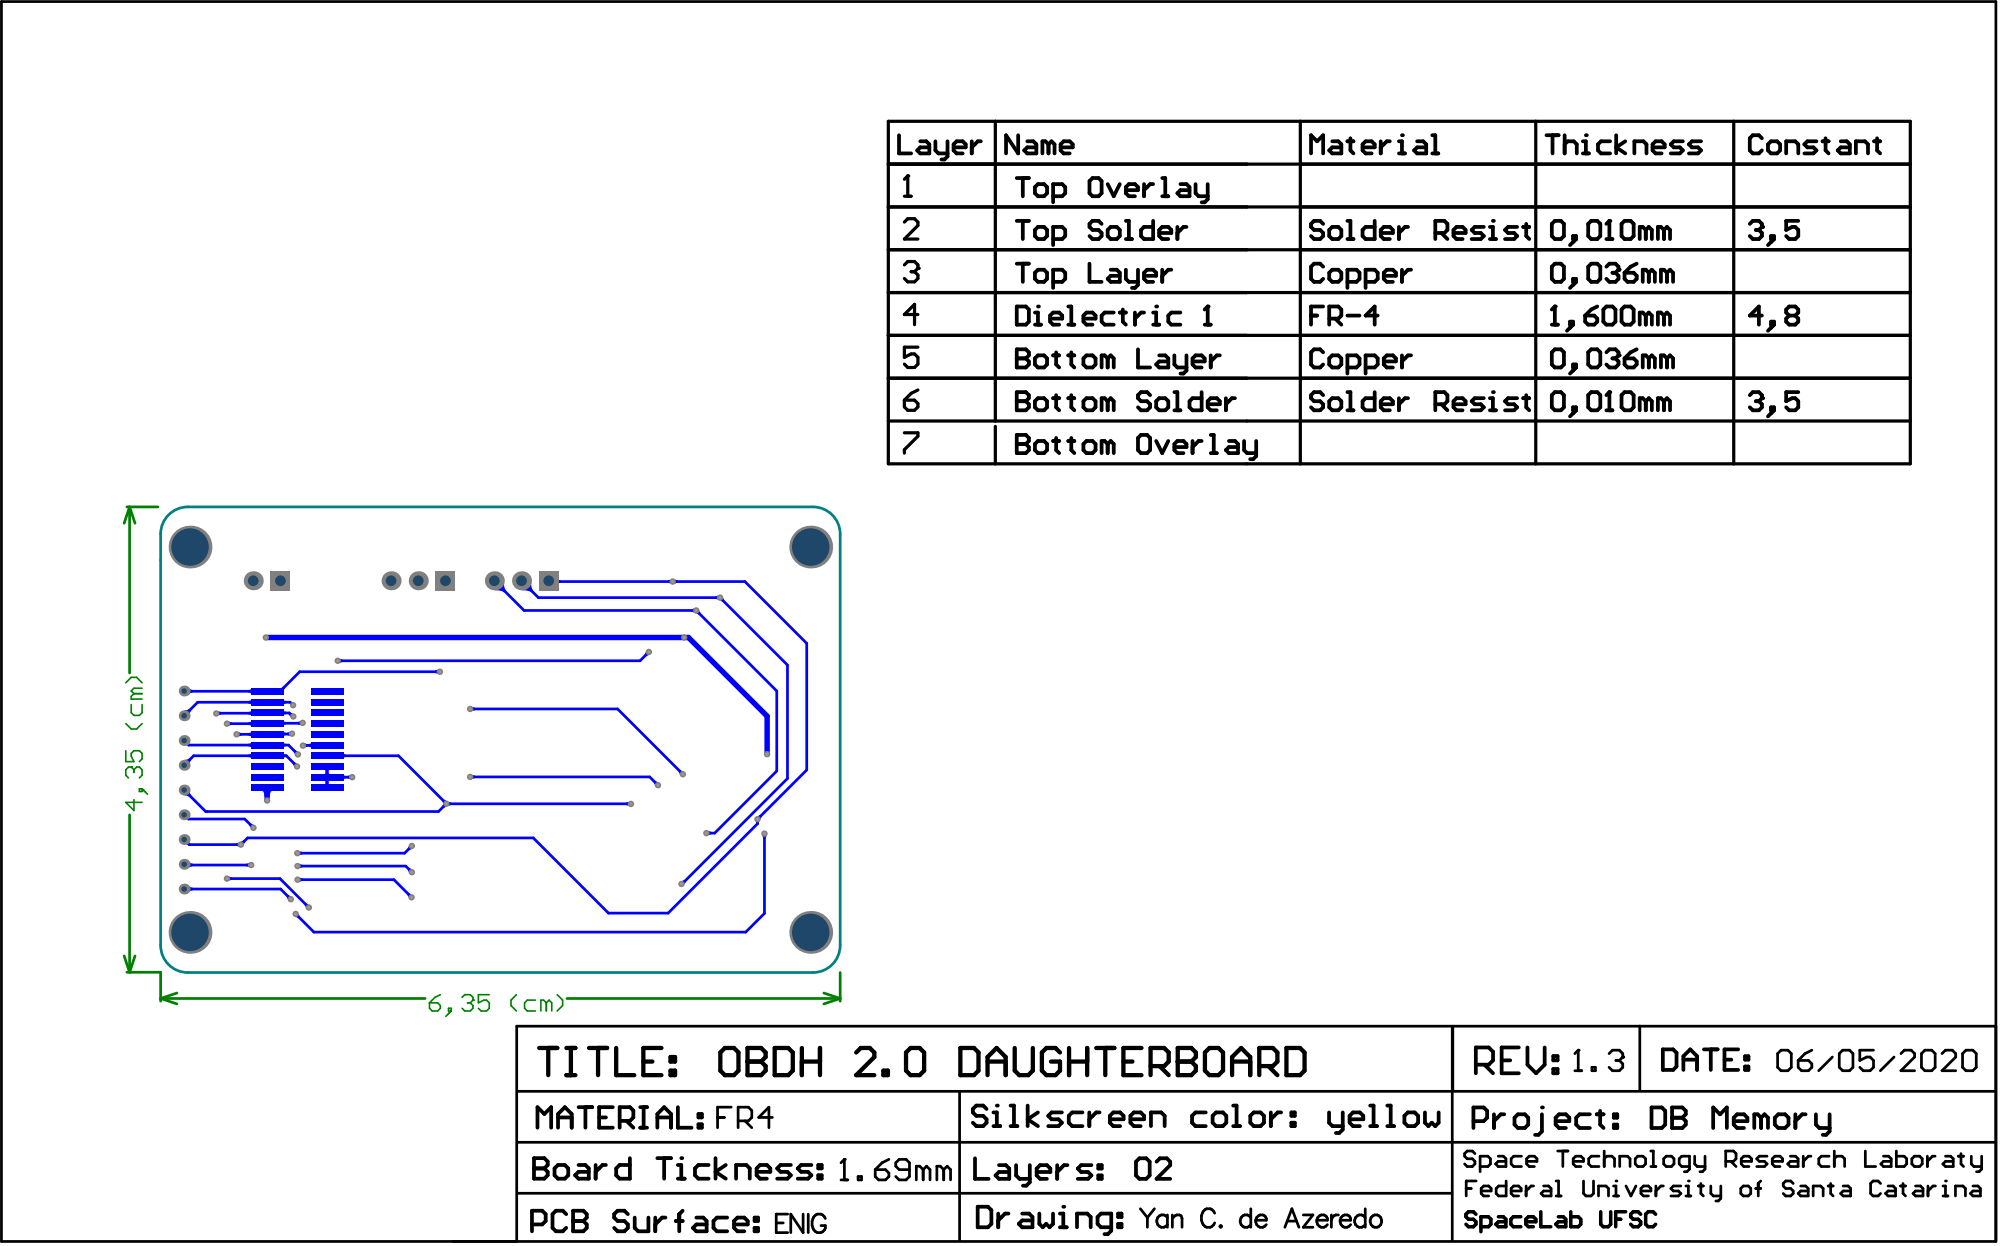
[picture p32: page 6]

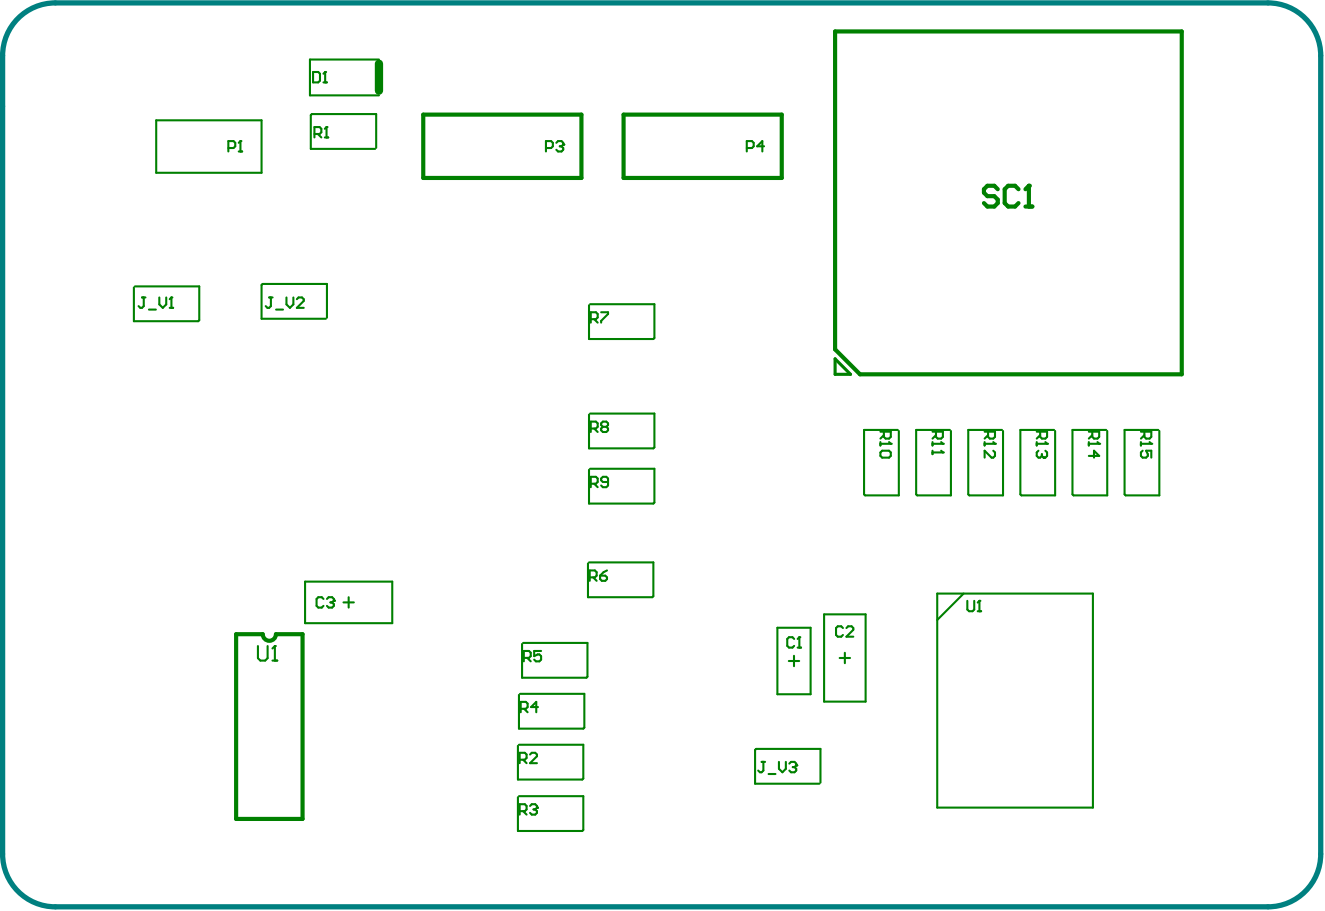
[picture p33: page 7]

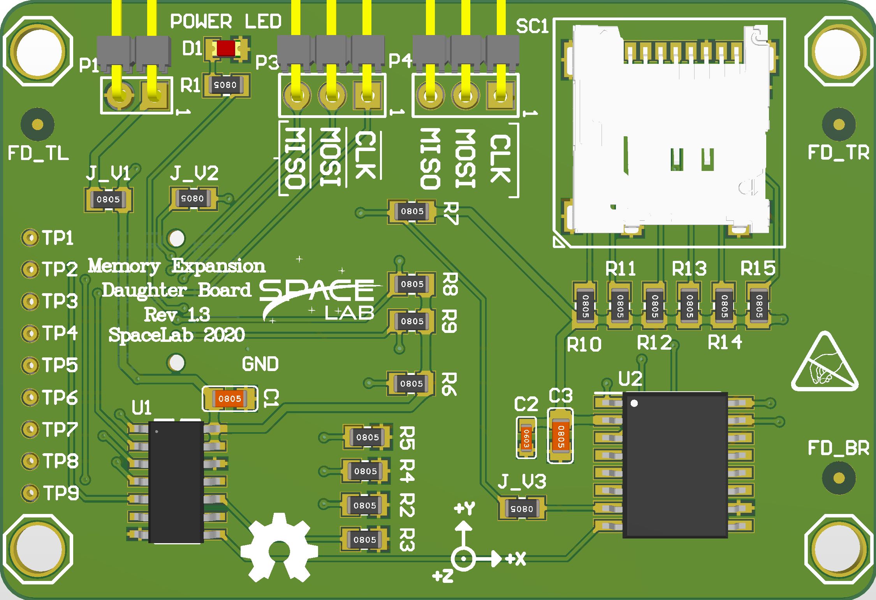
[picture p34: page 8]

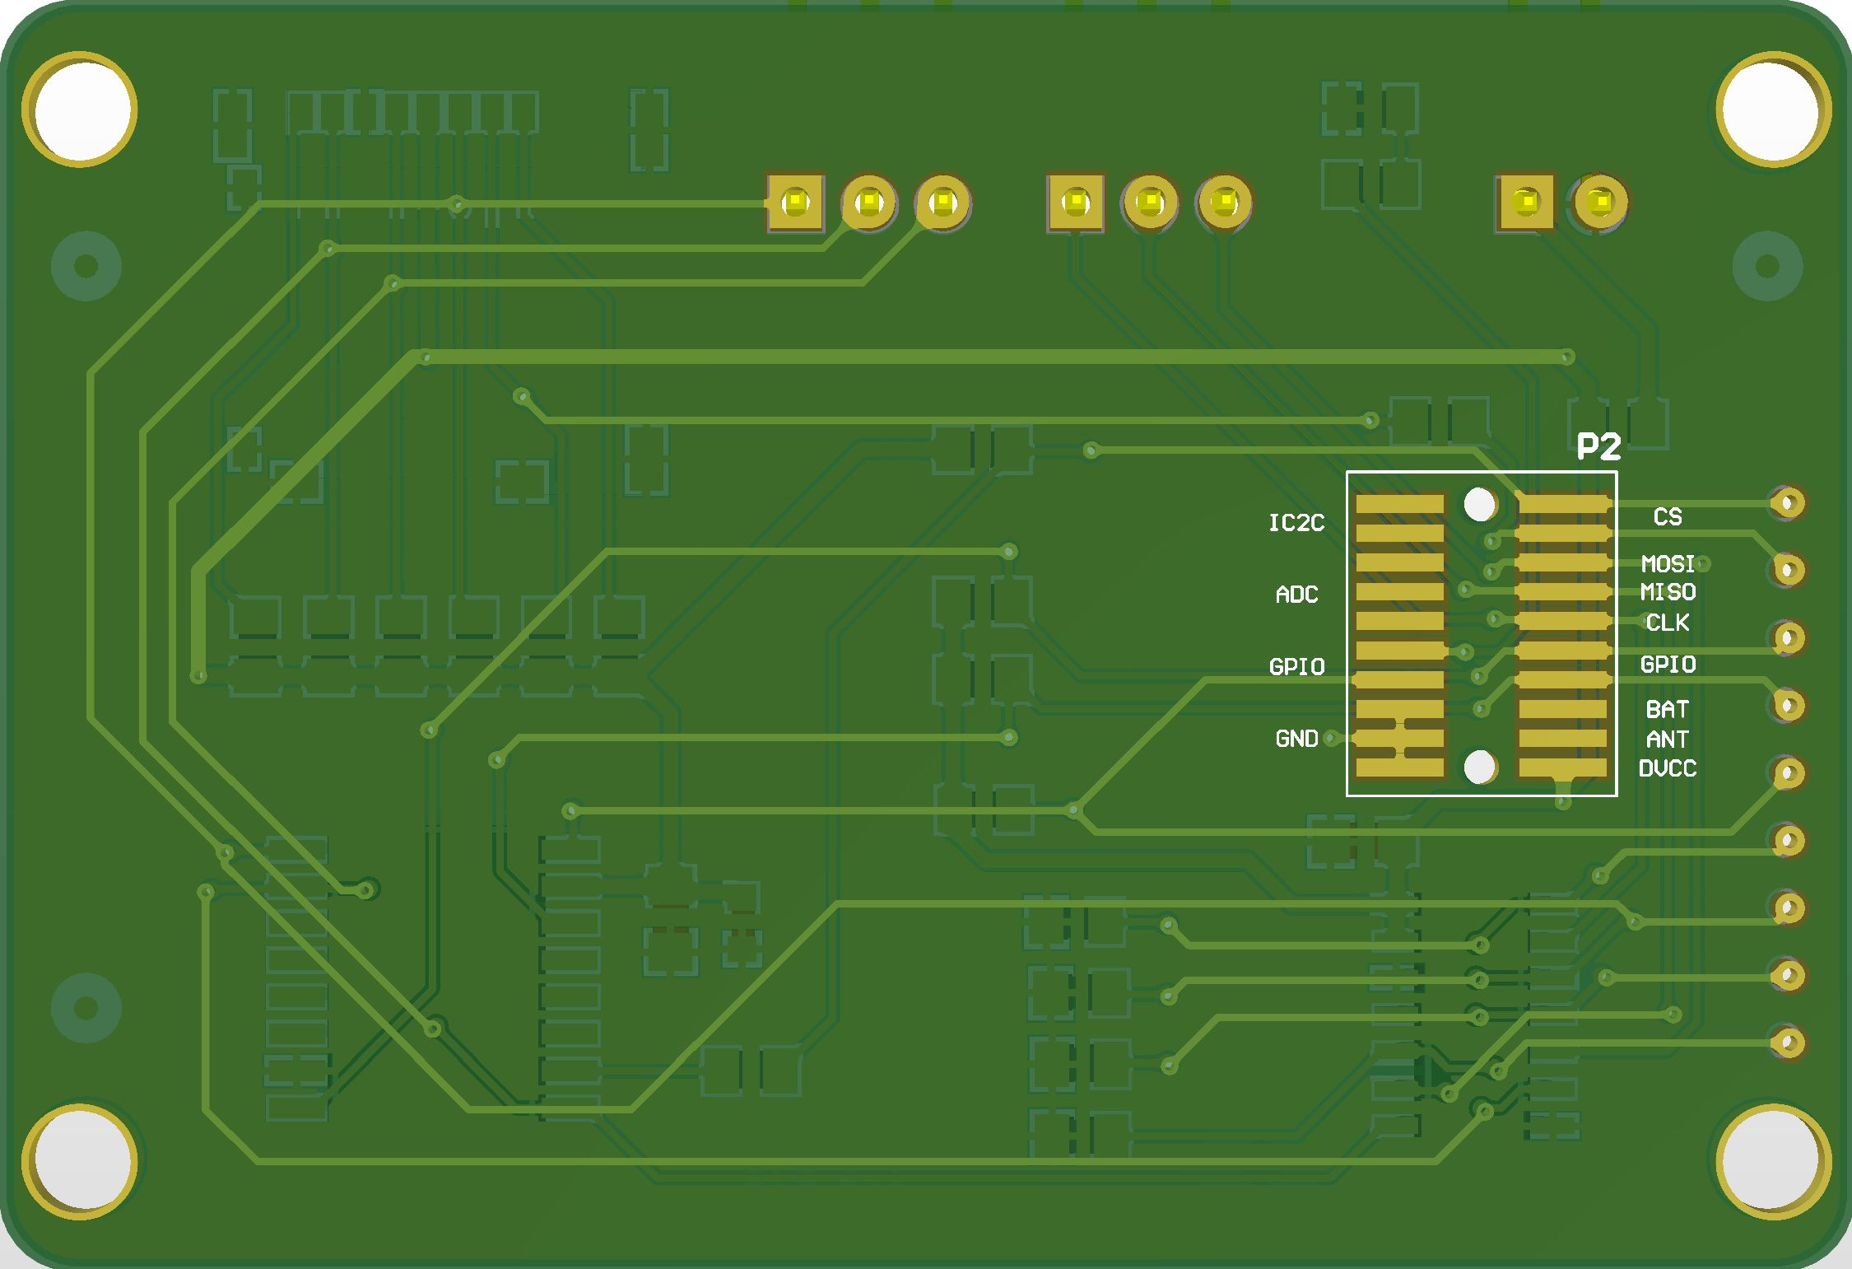
[picture p35: page 9]

Report Date: | 07/05/2020 | 11:22:10
Print Date: | 07/05/2020 | 11:22:30

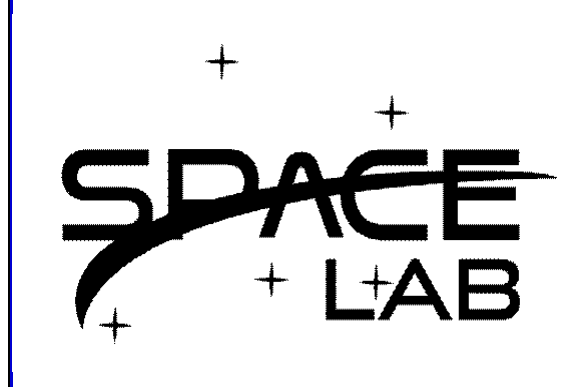
[picture p36: figure]

# | Supplier 1 | Supplier Part Number 1 | Supplier 2 | Supplier Part Number 2 | Manufacturer | Comment | Description | Quantity | Designator #Column Name Error:Fitted

1 | Digi-Key | 541-10.0KCCT-ND | Mouser | 71-CRCW0805-10K-E3 | Vishay | 10k | RES 10K OHM 1/8W 1% 0805 | 13 | R2, R3, R5, R6, R7, R8, R9, R10, R11, R12, R13, R14, R15
2 | Digi-Key | 311-0.0ARCT-ND | Mouser | 603-RC0805JR-070RL | Yageo | 0R | RES 0R OHM 1/8W JUMPER 0805 | 3 | J_V1, J_V2, J_V3
3 | Mouser | 200-TSW10308GSRA | Digi-Key | SAM1039-03-ND | Samtec | HEADER 3x | Conn Unshrouded Header HDR 3 POS 2.54mm Solder RA Thru-Hole Automotive Bulk | 2 | P3, P4
4 | Digi-Key | 160-1413-1-ND | Mouser | 859-LTST-C170KFKT | Vishay Lite-On | Orange | SMD Orange LED | 1 | D1
5 | Digi-Key | 296-1222-1-ND | Mouser | 595-SN74LVC125APWR | Texas Instruments | SN74LVC125APWR | IC BUF NON-INVERT 3.6V 14TSSOP | 1 | U1
6 | Digi-Key | 311-100KCRCT-ND | Mouser | 603-RC0805FR-07100KL | Yageo | 100k | RES 100K OHM 1/8W 1% 0805 | 1 | R4
7 | Digi-Key | 311-1141-1-ND | Mouser | 603-CC805KRX7R8BB104 | Yageo | 0.1uF/25V | CAP CER 0.1UF 25V 10% X7R 0805 | 1 | C1
8 | Digi-Key | 311-1401-1-ND | Mouser | 603-CC201KRX7R9BB101 | Yageo | 100nF/50V | CAP CER 100nF 50V 0603 10% | 1 | C2
9 | Digi-Key | 587-2990-6-ND | Mouser | 963-TMK212AB7475KG-T | Taiyo Yuden | 4.7uF/25V | CAP CER 4.7UF 25V 10% X7R 0805 | 1 | C3
10 | Digi-Key | 2019-RK73H2ATTD3300FCT-ND | Mouser | 660-RK73H2ATTD3300F | KOA Speer | 330R | RES 330R OHM 1/4W 1% 0805 | 1 | R1
11 | Mouser | 200-FSI11003GDAD | Digi-Key | SAM9412-ND | Samtec | FSI-110-03-G-D-AD | CONN STACKING 20POS SMD GOLD | 1 | P2
12 | Mouser | 200-TSW10208GSRA | Digi-Key | SAM1039-02-ND | Samtec | HEADER 2x | Conn Unshrouded Header HDR 2 POS 2.54mm Solder RA Thru-Hole Automotive Bulk | 1 | P1
13 | Mouser | 340-278808-TRAY | Digi-Key | 557-1789-ND | Micron Technology | MT25QL01GBBB8ESF-0SIT | NOR Flash Serial-SPI 3V 1Gbit 1024M/512M/256M x 1bit/2bit/4bit 6ns 16-Pin SOP-II | 1 | U2
14 | Mouser | 538-503182-1852 | Digi-Key | WM12834CT-ND | Molex | MicroSD Card Connector | MOLEX - 503182-1852 - Micro SD Normal UltraLowPro8CktEmbsTpPkg RoHS Compliant: Yes | 1 | SC1
| | Bill of Materials
Source Data From: | DB_Memory.PrjPCB
Project: | DB_Memory.PrjPCB
Variant: | None
Project Code: | <Parameter ProductCode not found>
