spacelab-ufsc/daughterboards/(list of files, drawings)

Other design files:
Memory_Expansion_Daughter_Board/hardware/DB_Memory.PrjPCB
Memory_Expansion_Daughter_Board/hardware/Source/0_Architecture.SchDoc
Memory_Expansion_Daughter_Board/hardware/Source/1_Interface.SchDoc
Memory_Expansion_Daughter_Board/hardware/Source/2_Non_Volatile_Memories.SchDoc
Memory_Expansion_Daughter_Board/hardware/Source/3_Communication_Buffers.SchDoc
Memory_Expansion_Daughter_Board/hardware/Source/DB_Memory.PcbDoc
Schematic_Templates/SpaceLabUFSC_SchematicTemplate_A4_Landscape.SchDoc
