spacelab-ufsc/daughterboards/(commit log)

2020-01-28 Memory_Expansion_Daughter_Board: initial files including still undeveloped schematics, pcb layout with right sized drilling and libraries into respective directories. Also added gitignore with conten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
    [0_Architecture.SchDoc, 1_Interface.SchDoc, 2_Non_Volatile_Memories.SchDoc, 3_Communication_Buffers.SchDoc, FSI-110-03-G-D-AD.stp, Memory_Expansion_Daughter_Board.PcbDoc, Memory_Expansion_Daughter_Board.PrjPCB]
2020-01-29 Memory_Expansion_Daughter_Board: Added diagram block for the project 0_Architecture schematic sheet
    [0_Architecture.SchDoc, Memory_Expansion_Daughter_Board.PrjPCB]
2020-01-29 Memory_Expansion_Daughter_Board: Updating diagram block of 0_Architecture schematic sheet showing now 3v3DCC and extra especifications in components and signals #1 #2
    [0_Architecture.SchDoc]
2020-01-30 Memory_Expansion_Daughter_Board: Added schematics for SPI buffer SN74LVC125APWR and 330 ohms resistor #3 #4 #5 #6
2020-01-30 Memory_Expansion_Daughter_Board: Added footprint and 3D model for SPI buffer SN74LVC125APWR, also added footprint of 0805 Tantalum capacitor (that still needs to be verified if it is going to be nece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
2020-01-30 Memory_Expansion_Daughter_Board: Initial components positioning and connections done in 1_Interface schematic sheet #3
    [1_Interface.SchDoc]
2020-01-31 Memory_Expansion_Daughter_Board: Added sheet symbol and ports in 1_interface sheet referencing 2_Non-Volatile_Memories sheet #3 #4
    [1_Interface.SchDoc]
2020-01-31 Memory_Expansion_Daughter_Board: Added schematic symbols, footprints and 3D models for debug Male Right Angle Header Pins of 2 and 3 positions #3 #6
    [Memory_Expansion_Daughter_Board.PrjPCB, TSW-102-08-G-S-RA.stp, TSW-103-08-G-S-RA.stp]
2020-01-31 Memory_Expansion_Daughter_Board: Moved MicroSDcard and memory into respective sheet, also placed net labels to ports connecting respective components pins #4
    [2_Non_Volatile_Memories.SchDoc]
2020-01-31 Memory_Expansion_Daughter_Board: Moved SPI buffer into respective sheet #5
    [3_Communication_Buffers.SchDoc]
2020-01-31 Memory_Expansion_Daughter_Board: Updating 0_Architecture sheet, now representing optional debug interface for SPI #1 #2
    [0_Architecture.SchDoc]
2020-01-31 Memory_Expansion_Daughter_Board: Added silk screen labels on 3 Pin Right Header Angle connector for debug SPI CLK, MOSI and MISO non-volatile-memories signals #3 #6
2020-01-31 Memory_Expansion_Daughter_Board: Added assembly drawing layers in Mechanical 15 layer for connectors, updated designators and components to schematic and silk screen for uSDcard #3 #6
    [1_Interface.SchDoc]
2020-01-31 Memory_Expansion_Daughter_Board: Updating designator and name of pins of SPI buffer #5 #6
2020-02-01 Memory_Expansion_Daughter_Board: Assigning initial inputs and outputs for SPI buffer, still needs to assign enables #5
    [3_Communication_Buffers.SchDoc]
2020-02-01 Memory_Expansion_Daughter_Board: Placing initial decopling capacitor 0.1uF/25V for SPI buffer #5
    [3_Communication_Buffers.SchDoc]
2020-02-01 Memory_Expansion_Daughter_Board: Syncronized ports of 3_Communication_Buffers sheet to 1_Interface sheet and done initial connections of FSI interface connector to buffer #3 #5
    [1_Interface.SchDoc]
2020-02-01 Memory_Expansion_Daughter_Board: Connecting inputs of non volatile memories symbol sheet to chip selects from FSI connector and to SPI buffed signals from buffer #3 #4
    [1_Interface.SchDoc, 2_Non_Volatile_Memories.SchDoc]
2020-02-01 Memory_Expansion_Daughter_Board: Connected FSI connector GPIOs 0, 1 and 2 to RESET, HOLD and W (write) non-volatile-memory pins respectively #3 #4
    [1_Interface.SchDoc]
2020-02-01 Memory_Expansion_Daughter_Board: Fixing wrong connection before SPI signals to buffer and chip selects CS0 CS1 for non-volatile-memory #3
    [1_Interface.SchDoc]
2020-02-01 Memory_Expansion_Daughter_Board: Added two 3x1 right angle pin connectors for debuging after and before SPI signals from buffer #3
    [1_Interface.SchDoc]
2020-02-01 Memory_Expansion_Daughter_Board: Added optional 2x1 right angle pin power header for testing the board without been supplied by OBDH 2.0 #3
    [1_Interface.SchDoc]
2020-02-02 Memory_Expansion_Daughter_Board: Added ground to all 3 inverted enables of the buffer and 3DVCC to unused pins corresponding to the fourth gate #5
    [3_Communication_Buffers.SchDoc]
2020-02-02 Memory_Expansion_Daughter_Board: Initial pull up resistors configuration done in communication buffers sheet, still needs to finish after some doubts answered #5
    [3_Communication_Buffers.SchDoc]
2020-02-02 Memory_Expansion_Daughter_Board: Added drilling holes for AT pins of FSI connector and updated silk screen and assembly layer #6
2020-02-04 Memory_Expansion_Daughter_Board: Modified project preferense to add Single '\' Notation, modified net labels on Communication Buffers sheet and ports in Interface sheets to considering the bar notati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
    [1_Interface.SchDoc, 3_Communication_Buffers.SchDoc]
2020-02-05 Memory_Expansion_Daughter_Board: Updated mating for FSI motherboard to daughterboard interface connector considering now the pads and silkcrenn in botton layer, drawed pins specification according to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
2020-02-06 Memory_Expansion_Daughter_Board: Updated silk screen for top overlay for all footprints in PCB library, now considering component designator and some extra info #6
2020-02-06 Memory_Expansion_Daughter_Board: Modified footprint of capacitors now having the MD version and no longe the HD (high density, pad size ~1.2mm) version, MD is easier to weld since the pad is bigger (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
2020-02-06 Memory_Expansion_Daughter_Board: Drawed pull down resistors to all 3 gates enables to always be enabled, 3V3DVCC to non used 4th gate enable (4OE) and GND to its input pin (4A) #5
    [3_Communication_Buffers.SchDoc]
2020-02-08 Memory_Expansion_Daughter_Board: Drawed pull up and pull down resistors to non-volatile-memory in schematic sheet, needs revision #4
    [2_Non_Volatile_Memories.SchDoc]
2020-02-09 Memory_Expansion_Daughter_Board: Updated 3D model for non-volatile-memory MT25QL01GBBB8ESF-0SIT in schematic and pcb libraries #6
2020-02-09 Memory_Expansion_Daughter_Board: Added step files for 3D models used in all components #6
    [PW14.step, User Library-0805(2012M) Cap.step, User Library-0805(2012M) Res.step, User Library-IPC SO.step, User Library-led_0805.step]
2020-02-09 Memory_Expansion_Daughter_Board: Added the .png and .drawio to latest architecture of the Memory Expansion Daughter Board (DB is short for daughter board) #1 #2
2020-02-09 Memory_Expansion_Daughter_Board: Runned Update Schematic Annotation tool for all schematic sheets, all components now have their own designator #3 #4 #5
    [1_Interface.SchDoc, 2_Non_Volatile_Memories.SchDoc, 3_Communication_Buffers.SchDoc, Memory_Expansion_Daughter_Board.PrjPCB]
2020-02-10 Memory_Expansion_Daughter_Board: Alligned all components in schematics to grid #3 #4 #5
    [1_Interface.SchDoc, 2_Non_Volatile_Memories.SchDoc, 3_Communication_Buffers.SchDoc]
2020-02-11 Memory_Expansion_Daughter_Board: Updated schematic and pcb library with the correct footprint and 3D models for 0805 and 0603 capacitors
2020-02-11 Memory_Expansion_Daughter_Board: Added 3D model for 0603 ceramic capacitor that was missing
    [User Library-0603(1608M) Cap.step]
2020-02-11 Memory_Expansion_Daughter_Board: Updated decoupling capacitors for non-volatile-memorie with a 100nF/50V and 4.7uF/25V ceramic capacitors #4
    [2_Non_Volatile_Memories.SchDoc]
2020-02-11 Memory_Expansion_Daughter_Board: Updated single 0.1uF/25V decoupling capacitor for buffer with new 0805 3D model #5
    [3_Communication_Buffers.SchDoc]
2020-02-12 Memory_Expansion_Daughter_Board: Resolved compiling errors on all schematics, only warnings about net wires with multiple names and off grid components remain #6
    [1_Interface.SchDoc, 2_Non_Volatile_Memories.SchDoc, 3_Communication_Buffers.SchDoc, Memory_Expansion_Daughter_Board.PrjPCB]
2020-02-14 Memory_Expansion_Daughter_Board: Updated some footprints for components in schematics with the footprint manager
    [1_Interface.SchDoc, 2_Non_Volatile_Memories.SchDoc]
2020-02-14 Memory_Expansion_Daughter_Board: First time updating pcb documment with no errors showing while executing changes #6
    [Memory_Expansion_Daughter_Board.PcbDoc]
2020-02-14 Memory_Expansion_Daughter_Board: Successfully positioned the FSI connector to respective place in PCB according to measurements in 3_connector_position.PNG file #6
    [Memory_Expansion_Daughter_Board.PcbDoc]
2020-02-14 Memory_Expansion_Daughter_Board: Adding new repository for DB sizes/measurements and a image of the FSI connector positioning on PCB
2020-02-17 Memory_Expansion_Daughter_Board: Updated 3D model of 2 pin male power header for the right angle version #6
    [1_Interface.SchDoc, Memory_Expansion_Daughter_Board.PcbDoc]
2020-02-17 Memory_Expansion_Daughter_Board: Updated footprints by removing silkscreen designators, because the PCB layout already had them #6
    [Memory_Expansion_Daughter_Board.PcbDoc, Memory_Expansion_Daughter_Board.PrjPCB]
2020-02-17 Memory_Expansion_Daughter_Board: Removed silkscreen designators for resistors footprints #6
    [Memory_Expansion_Daughter_Board.PcbDoc]
2020-02-17 Memory_Expansion_Daughter_Board: Initial components positioning #6
    [Memory_Expansion_Daughter_Board.PcbDoc]
2020-02-17 Memory_Expansion_Daughter_Board: Updated silkscreen labels for pins in FSI connector (mirrored to show at botton layer) #6
    [Memory_Expansion_Daughter_Board.PcbDoc]
2020-02-17 Memory_Expansion_Daughter_Board: Configured solder mask, layers and dielectric to thickmess standards in OBDH 2.0 #6
    [Memory_Expansion_Daughter_Board.PcbDoc]
2020-02-17 Memory_Expansion_Daughter_Board: Imported PCB rules from OBDH 2.0 for project #6
    [Memory_Expansion_Daughter_Board.PcbDoc]
2020-02-18 Memory_Expansion_Daughter_Board: Initial routing and positioning of all components #6
    [Memory_Expansion_Daughter_Board.PcbDoc]
2020-02-19 Memory_Expansion_Daughter_Board: Fixed pads designators for FSI connector according to OBDH 2.0 and 3D model position considering pcb thickness #6
2020-02-19 Memory_Expansion_Daughter_Board: Fixed CLK, MISO and MOSI connections to buffer in interface sheet and updated pcb document #6
    [1_Interface.SchDoc, Memory_Expansion_Daughter_Board.PcbDoc]
2020-02-19 Memory_Expansion_Daughter_Board: Updated headers hole sizes in footprints and pcb document #6
    [Memory_Expansion_Daughter_Board.PcbDoc]
2020-02-20 Memory_Expansion_Daughter_Board: Routed every net connection and added ground plane to top layer #6
    [Memory_Expansion_Daughter_Board.PcbDoc]
2020-02-21 Memory_Expansion_Daughter_Board: Changed routing beneath buffer adding extra vias, modified silkcreen and position of debug headers and added GND planes in both sides #6
    [Memory_Expansion_Daughter_Board.PcbDoc]
2020-02-21 Memory_Expansion_Daughter_Board: Changed GND via to the same size as OBDH 2.0 #6
    [Memory_Expansion_Daughter_Board.PcbDoc]
2020-02-22 Memory_Expansion_Daughter_Board: Added initial custom schematic template from SpaceLab
    [1_Interface.SchDoc, 2_Non_Volatile_Memories.SchDoc, 3_Communication_Buffers.SchDoc, SpaceLabUFSC_SchematicTemplate_A4_Landscape.SchDoc]
2020-02-22 Memory_Expansion_Daughter_Board: Added excel checklist for the project, initial comments and revision done
    [PCB Design Checklist.xlsx]
2020-02-24 Memory_Expansion_Daughter_Board: Added 0 ohms resistor jumper to power test pin connector #6
    [1_Interface.SchDoc, Memory_Expansion_Daughter_Board.PcbDoc, Memory_Expansion_Daughter_Board.PrjPCB]
2020-02-24 Memory_Expansion_Daughter_Board: Changed power track 3V3 width to 0.508 mm (OBDH 2.0 standard) #6
    [Memory_Expansion_Daughter_Board.PcbDoc]
2020-02-24 Memory_Expansion_Daughter_Board: Initial placement of drill table #6
    [Memory_Expansion_Daughter_Board.PcbDoc]
2020-02-26 Memory_Expansion_Daughter_Board: Added mechanical holes and fidutials schematic symbols and pcb footprints #6
2020-02-26 Memory_Expansion_Daughter_Board: Added mechanical and fidutials to 1_Interface schematic sheet #6
    [1_Interface.SchDoc]
2020-02-26 Memory_Expansion_Daughter_Board: Updated PCB with mechanical holes (replaced mechanicals ones done only on the document) and fidutials #6
    [Memory_Expansion_Daughter_Board.PcbDoc]
2020-02-26 Memory_Expansion_Daughter_Board: Added SpaceLab logo to silkcreen and repositioned FloripaSat patch #6
    [Memory_Expansion_Daughter_Board.PcbDoc]
2020-02-26 Memory_Expansion_Daughter_Board: Updated PCB Design Checklist, still needing a lot of topics to cover #6
    [PCB Design Checklist.xlsx]
2020-02-26 Memory_Expansion_Daughter_Board: Added and modified designators for assembly drawing layer (mechanical 15) #6
    [Memory_Expansion_Daughter_Board.PcbDoc]
2020-02-26 Memory_Expansion_Daughter_Board: Changed GND net to EARTH for mechanical holes and added table of revision history in 1_Interface schematic sheet #6
    [1_Interface.SchDoc]
2020-02-26 Memory_Expansion_Daughter_Board: Repoured all polygons of GND plane with the new EARTH net assigned to mechanical holes #6
    [Memory_Expansion_Daughter_Board.PcbDoc]
2020-02-26 Memory_Expansion_Daughter_Board: Small changes to components positioning in shematic sheets, edited template schematic fields and updated features information
    [1_Interface.SchDoc, 2_Non_Volatile_Memories.SchDoc, 3_Communication_Buffers.SchDoc]
2020-02-26 Memory_Expansion_Daughter_Board: Tented all vias on top and botton layers #6
    [Memory_Expansion_Daughter_Board.PcbDoc]
2020-02-26 Memory_Expansion_Daughter_Board: Updated checklist for all schematic and pcb layout itens, question marks were placed when there is doubt #6
    [PCB Design Checklist.xlsx]
2020-02-29 Changes to daughterboard repository structure for dev_hardware branch
    [0_Architecture.SchDoc, 1_Interface.SchDoc, 2_Non_Volatile_Memories.SchDoc, 3_Communication_Buffers.SchDoc, FSI-110-03-G-D-AD.stp, Memory_Expansion_Daughter_Board.PcbDoc, Memory_Expansion_Daughter_Board.PrjPCB, PCB Design Checklist.xlsx]
2020-02-29 Memory_Expansion_Daughter_Board: Updated footprint for FSI connector in PCB document by removing the 3D model for the Multi Board Assemble project #6 #7
    [Memory_Expansion_Daughter_Board.PcbDoc]
2020-03-01 Memory_Expansion_Daughter_Board: Modified FSI connector properties to include name: "System" and value: "Connector" for multi board assembly #7
    [1_Interface.SchDoc]
2020-03-01 Memory_Expansion_Daughter_Board: Multi_Board_Assembly_with_obdh2 : Initial assemble of the DB variant and OBDH 2.0 pcbs, ignoring errors related to connections #7
2020-03-01 Memory_Expansion_Daughter_Board: Updated PCB with new rules for GND polygon with 4 connections in 90° angle on top and botton layer #6
    [Memory_Expansion_Daughter_Board.PcbDoc]
2020-03-01 Memory_Expansion_Daughter_Board: Added first files to new documentation (doc) directory, such as readme.md, gitignore, datasheets for buffer, memories and pcb layout guideline
2020-03-01 Memory_Expansion_Daughter_Board: Multi_Board_Assembly_with_obdh2 : Added images of first initial assemble with the rev 1.0 of Memory Expasion Daughter Board (DB_ME) #7
2020-03-02 Memory_Expansion_Daughter_Board: Updated footprints for mounting holes in PCB and FSI connector
    [Memory_Expansion_Daughter_Board.PcbDoc]
2020-03-02 Added images for the interface conector FSI-110-03-G-D-AD pads, holes and position on Daughter Board generic design
2020-03-04 Memory_Expansion_Daughter_Board: Alligned test points to horizontal axis and to have the same distance vertically #6
    [Memory_Expansion_Daughter_Board.PcbDoc]
2020-03-04 Memory_Expansion_Daughter_Board: Updated mouting holes leaving only number 4 (top right corner) directly connected to GND #6
    [1_Interface.SchDoc, Memory_Expansion_Daughter_Board.PcbDoc]
2020-03-04 Memory_Expansion_Daughter_Board: Updated footprint for fidutials in library and pcb and added silkcreen symbols #6
    [Memory_Expansion_Daughter_Board.PcbDoc]
2020-03-12 Memory_Expansion_Daughter_Board: Added layer stack table to new layer "sheet" (mechanical type)
    [Memory_Expansion_Daughter_Board.PcbDoc]
2020-03-19 Memory_Expansion_Daughter_Board: Changed fidutials to match with the same done in OBDH 2.0
    [1_Interface.SchDoc, Memory_Expansion_Daughter_Board.PcbDoc]
2020-03-19 Memory_Expansion_Daughter_Board: Added 0 ohms resistors jumpers for chip selection on both memories
    [2_Non_Volatile_Memories.SchDoc, Memory_Expansion_Daughter_Board.PcbDoc]
2020-03-19 Memory_Expansion_Daughter_Board: Modified layers for 3D bodies in PCB library and updated in PCB documment, also drawed Keep-Out-Layer and Board Outline Layer
    [Memory_Expansion_Daughter_Board.PcbDoc]
2020-03-19 Memory_Expansion_Daughter_Board: Removed some of the GND planes betwem resistors pads and some excessive ones that didn't have funcionality
    [Memory_Expansion_Daughter_Board.PcbDoc]
2020-03-20 Updated template for (still) manual inclusion of paremeters
    [SpaceLabUFSC_SchematicTemplate_A4_Landscape.SchDoc]
2020-03-20 Memory_Expansion_Daughter_Board: Modified shematic sheets to new hiearchy of project to include 0_Architecture.SchDoc file #12
    [0_Architecture.SchDoc, 1_Interface.SchDoc, 2_Non_Volatile_Memories.SchDoc, 3_Communication_Buffers.SchDoc, Memory_Expansion_Daughter_Board.PcbDoc]
2020-03-20 Memory_Expansion_Daughter_Board: Finished PCB layout for version 1.1 of the project #6
    [Memory_Expansion_Daughter_Board.PrjPCB]
2020-03-20 Finished assembly of DaughterBoard Expansion Memory v1.1 with OBDH 2.0 Eng Model 2 #7
2020-03-20 Renaming PCB project related files from the old "Memory_Expansion_Daughter_Board" to the new "DB_Memory"
    [DB_Memory.PcbDoc, DB_Memory.PrjPCB]
2020-03-20 DB_Memory: Refreshing .PrjPCB file with adding PCB file lost in reanaming project
    [DB_Memory.PrjPCB]
2020-03-21 DB_Memory: Updated all paremeters for components in schematic library for first BOM file generation, syncronized library for all shematic scheets #12
    [0_Architecture.SchDoc, 1_Interface.SchDoc, 2_Non_Volatile_Memories.SchDoc, 3_Communication_Buffers.SchDoc, DB_Memory.PrjPCB]
2020-03-21 DB_Memory: Removed top assembly symbol for FSI connector and test points, added sylkcreen to top and botton GND vias and updated PCB documment with new parameters from sheets #12
    [DB_Memory.PcbDoc]
2020-03-21 DB_Memory: Adding template and manually updated spreadsheet of BOM #12
    [BOM Template.xlsx, Bill of Materials-DB_Memory.xlsx]
2020-03-22 DB_Memory: doc: Adding pictures of the 3D model of PCB v1.1
2020-03-22 DB_Memory: hardware: Updated rule for direct contact on upright mechanical hole of PCB and repouring GND polygon
    [DB_Memory.PcbDoc]
2020-03-24 Modified .gitignore file of the root directory of the repository to avoid history and __preview related files of schematic templates
2020-03-24 DB_Memory: Updatig header pins, SD card connector and non-volatile-memory paremeters in PCB and shematic sheets for "final" BOM file generation #12
    [0_Architecture.SchDoc, 1_Interface.SchDoc, 2_Non_Volatile_Memories.SchDoc, 3_Communication_Buffers.SchDoc, DB_Memory.PcbDoc]
2020-03-24 DB_Memory: Updated BOM for PDF v1.1 of project and finished configuring .OutJob file #12
2020-03-24 DB_Memory: Finished all output files for project v1.1 #12 #15
    [BOM Template.xlsx, Bill of Materials-DB_Memory.xlsx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]
2020-03-24 DB_Memory: Latest update on PCB checklist and waiting for final revision of v1.1 realease
    [PCB Design Checklist.xlsx]
2020-03-24 DB_Memory: Updating project file after output files first releases
    [DB_Memory.PrjPCB]
2020-03-24 DB_Memory: Updated all files with the new description of 0 ohms jumper resistor (before with 1/16W now with 1/8W)
    [1_Interface.SchDoc, 2_Non_Volatile_Memories.SchDoc, Bill of Materials-DB_Memory.xlsx, DB_Memory.PcbDoc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]
2020-04-10 DB_Memory: Added "not - negation" bar symbol to not buffed SPI signals
    [DB_Memory.PcbDoc]
2020-04-10 DB_Memory: Adding the "open hardware" logo to the PCB.
    [DB_Memory.PcbDoc]
2020-04-18 DB_Memory: hw: Changed sheet symbols names for respective circuits description
    [1_Interface.SchDoc, DB_Memory.PcbDoc]
2020-04-18 DB_Memory: layout: Repositioned decopling capacitor for buffer
    [DB_Memory.PcbDoc]
2020-04-18 DB_Memory: layout: Changed power track width of optional "POWER TEST" header to the default 0.508 mm
    [DB_Memory.PcbDoc]
2020-04-18 DB_Memory: layout: Changed board labels for the new standard on OBDH 2.0 motherboard
    [DB_Memory.PcbDoc]
2020-04-18 DB_Memory: layout: Removed FloripaSat patch and added ESD symbol and revision number on silkscreen
    [DB_Memory.PcbDoc]
2020-04-20 DB_Memory: layout: Updated hole sizes for debbug pin headers to 0.9 mm
    [DB_Memory.PcbDoc]
2020-04-20 DB_Memory: layout: Added teardrops to pcb design and repositioned tracks on botton layer located on the FSI connector region
    [DB_Memory.PcbDoc]
2020-04-20 DB_Memory: layout: Re-annoted designators on pcb design to schematics, recopiled project and updated pcb document
    [DB_Memory.PcbDoc]
2020-04-20 DB_Memory: Finished the revision 1.2
    [0_Architecture.SchDoc, 1_Interface.SchDoc, 2_Non_Volatile_Memories.SchDoc, 3_Communication_Buffers.SchDoc, DB_Memory.PcbDoc, DB_Memory.PrjPCB]
2020-04-20 DB_Memory: Finished PCB Design Checklist
    [PCB Design Checklist.xlsx]
2020-04-20 DB_Memory: doc: Updated block diagrams and PCB top and botton view images to revision 1.2
2020-04-20 DB_Memory: doc: Updated output files and documentation with revision 1.2 closes #20
    [Bill of Materials-DB_Memory.xlsx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]
2020-04-20 DB_Memory: schematic: Updated custom schematic template
    [SpaceLabUFSC_SchematicTemplate_A4_Landscape.SchDoc]
2020-05-06 DB_Memory: schematic: Added description for revision 1.3 and updated fidutials and mechanical holes with "Standard (no BOM)" parameter
    [0_Architecture.SchDoc]
2020-05-06 DB_Memory: layout: Removed GND plane for bottom layer, deleted not used GND vias, updated Drill Table and other minor track changes
    [DB_Memory.PcbDoc]
2020-05-06 DB_Memory: Added date to revision 1.3 in version control table on schematic sheet and in PCB document
    [0_Architecture.SchDoc, DB_Memory.PcbDoc]
2020-05-06 DB_Memory: libraries: Modified parameter type for fidutials and mechanical holes symbols to "Standard (no BOM)"
2020-05-07 DB_Memory: libraries: layout: Removing top and bottom solder in mechanical mouting holes (AD) in FSI connector
    [DB_Memory.PcbDoc]
2020-05-07 DB_Memory: Refreshing project file for 1.3 revision
    [DB_Memory.PrjPCB]
2020-05-07 DB_Memory: Updating output files for project revision 1.3
    [Bill of Materials-DB_Memory.xlsx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]
2020-05-07 DB_Memory: documentation: Deleting old figures of top and bottom view of the board and adding new ones
2020-05-07 DB_Memory: Updating readme file on root directory to include new pictures of the rev 1.3 board
